AKUINO/MICHA/README.md

# MICHA
Modbus Interface to Control Heat and Actuators
