AKUINO/MICHA/MICHA20/Technical documentations/MICHA20_internalPinMatching.jpg

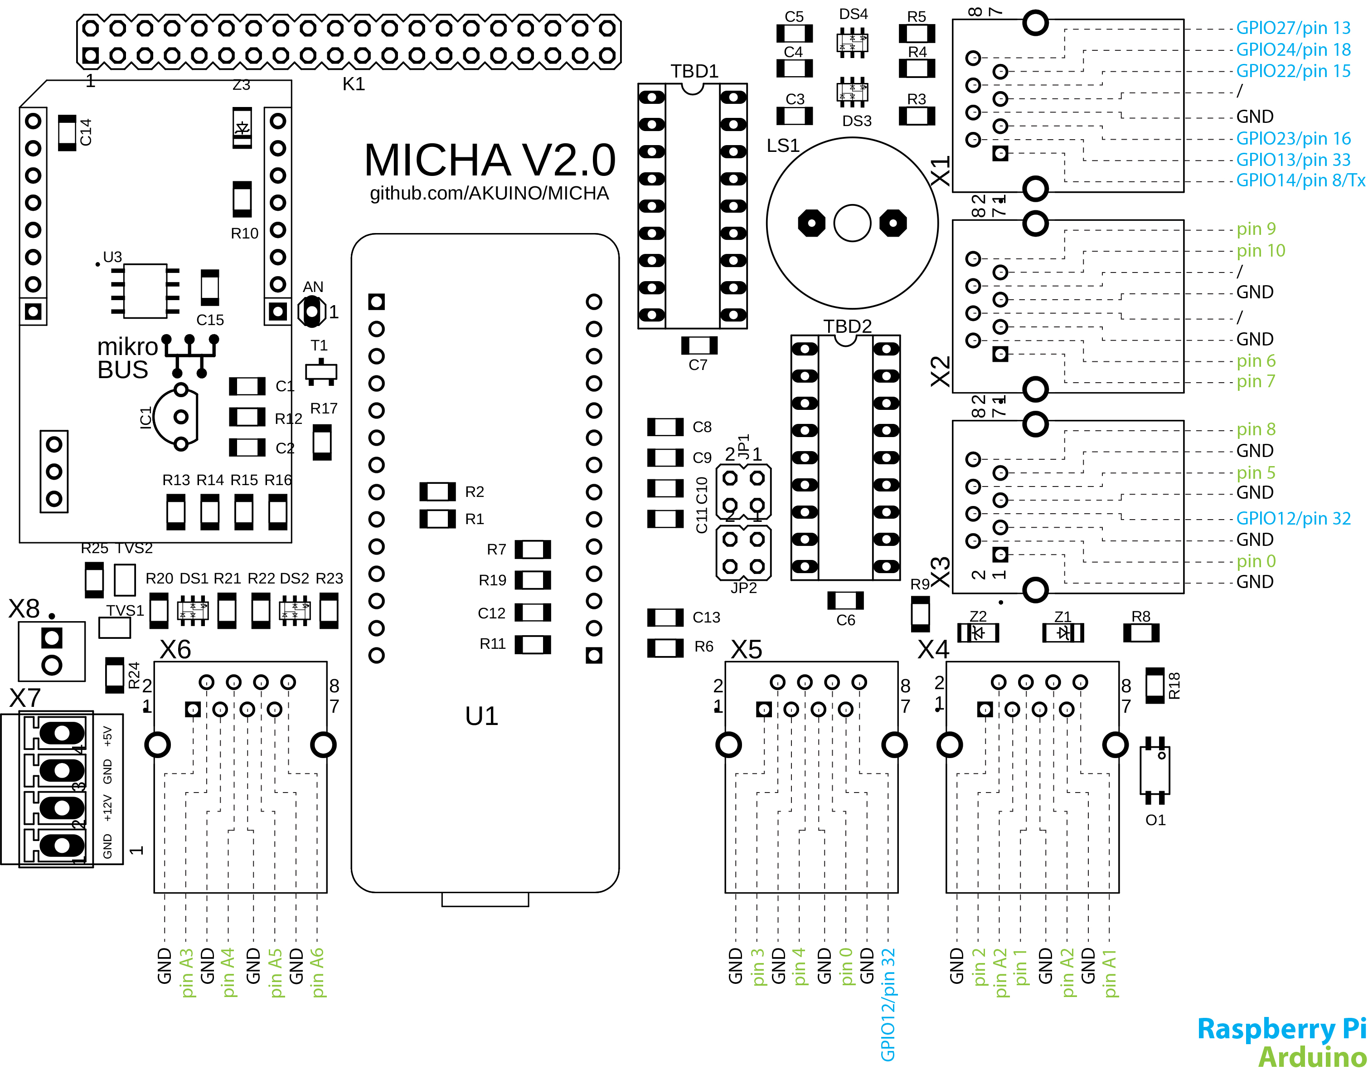
MICHA20/Technical documentations/MICHA20_internalPinMatching.jpg
