AKUINO/MICHA/MICHA20/Technical documentations/principleDiagram.jpg

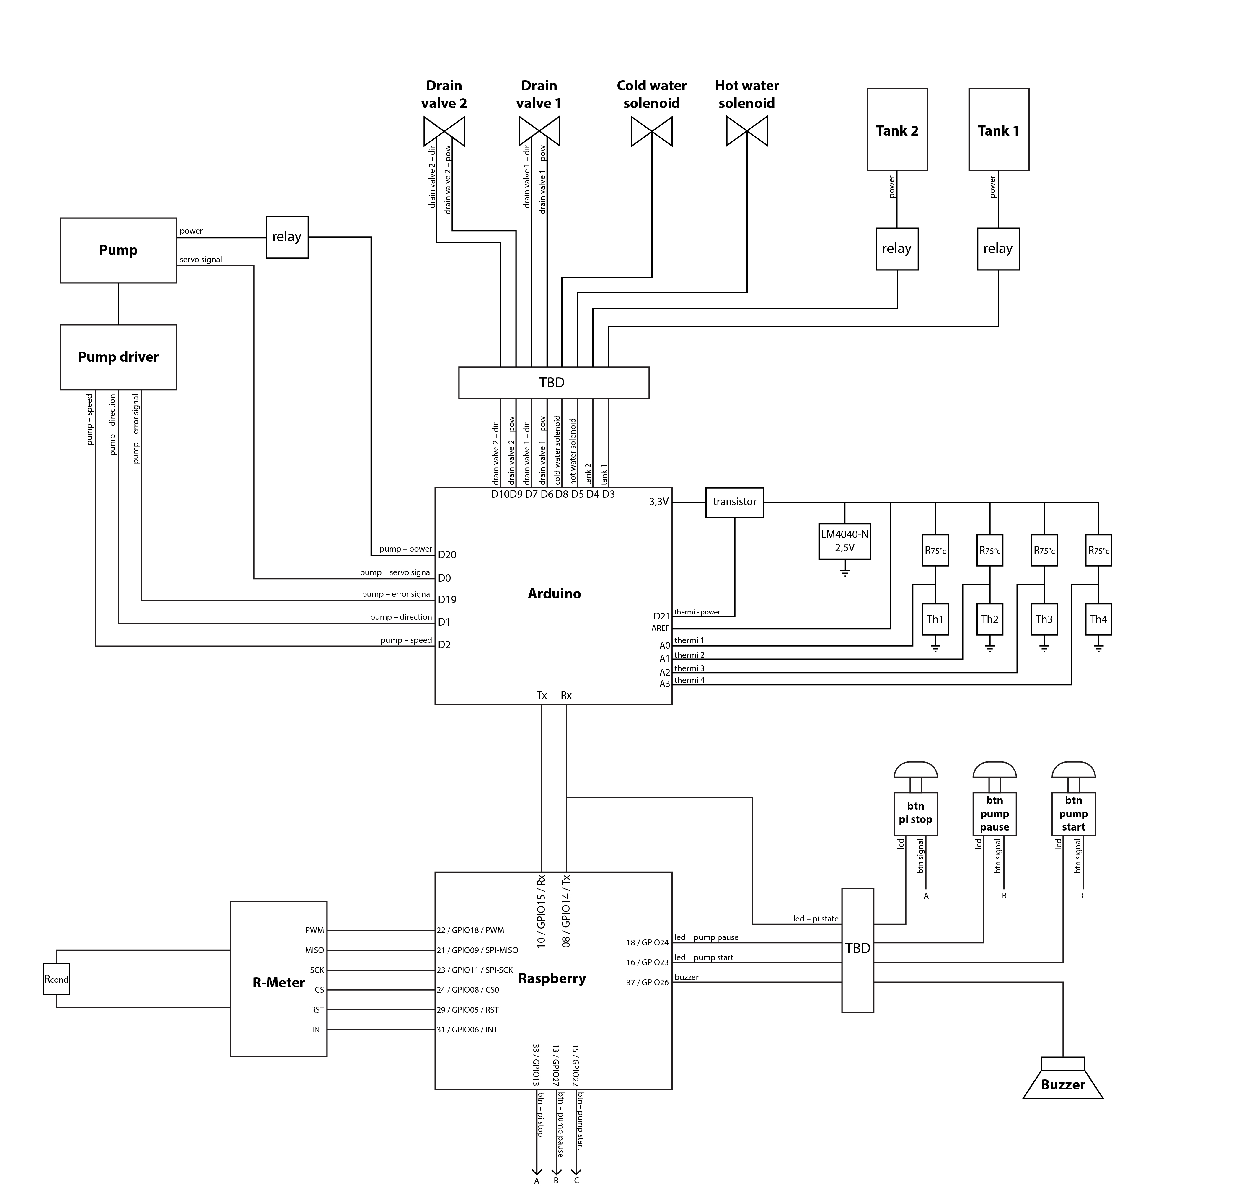
MICHA20/Technical documentations/principleDiagram.jpg
