AKUINO/MICHA/MICHA50/Technical documentations/MICHA50_BOM_PCB.pdf

### MICHA_V5.0

Prix toyal HT : | 172,27 €
Reference | Schematic Ref. | Type | Description | R o H S
U
E | Qty Stock | To
| | | | | | | order | unit | Unit€ | Transp€ | EXT | U R L
| | | | | | | | | | | | 1 U R L
| | | | | | | | | | | | 2 U R L
| | | | | | | | | | | | 3 BOM Note
NBR PASTO: | 2
C1206C104K5RACTU/GR0004 | C1-C5 | Capacitor | Condensateur tantal 100nF 1206 (3216) | (Y) | 5 | 118 | 0 | / | 0,12 € | ? | 0,62 € | https://be.farnell.com/fr-BE/kemet/c1206c104k5ractu/condensateur-0-1-f-50v-10-x7r/dp/1414715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
CL31B105KAHNNNE/GR0003 | C6 | Capacitor | Condensateur céramique 1µF 1206(3216) | (Y) | 1 | 88 | 0 | / | 0,04 € | ? | 0,04 € | https://www.mouser.be/ProductDetail/Samsung-Electro-Mechanics/CL31B105KAHNNNE?qs=349EhDEZ59p5FHnPIxx1UQ%3D%3D
C1206C103J1RACTU | C7-C10 | Capacitor | Condensateur céramique 10nF 1206 (3216) | (Y) | 4 | 73 | 0 | / | 0,09 € | ? | 0,36 € | C1206C103J1RACTU (https://www.tme.eu/be/fr/details/c1206c103j1ractu/condensateurs-mlcc-smd-1206/kemet/) KEMET - Condensateur: céramique | MLCC; 10nF; 100VDC; X7R; ±5%; SMD; 1206 | TME - Composants électroniques
CMXSH2-4LSTRPBFREE | DS1-DS5 | Diode | Diode Schottky 0,42V SOT-26 | (Y) | 5 | 17 | 0 | / | 0,75 € | ? | 3,77 € | CMXSH2-4LS (https://www.mouser.be/ProductDetail/Central-Semiconductor/CMXSH2-4LS-TR-PBFREE?qs=u16ybLDytRbULv8il3sGwg%3D%3D) TR PBFREE Central Semiconductor | Mouser Belgique
0ZCJ0005FF2E | F1 | Protection | Fusible réarmable 50mA | (Y) | 1 | 9 | 0 | / | 0,11 € | ? | 0,11 € | https://www.mouser.be/ProductDetail/Bel-Fuse/0ZCJ0005FF2E?qs=sGAEpiMZZMtJbfcMcIM8CEEKpmRzSeLfp9xT10Llxtc%3D https://be.farnell.com/fr-BE/bel-fuse-circuit-protection/0zcj0005ff2e/fusible-ctp-rearmable-60vdc-0/dp/2834879 Protection contre les court-circuits de X2, X4 et PUMP_DIR
LM4040AIM3X-2.5/GR0011 | IC1 | Diode | Référentiel de tension 2,5V SOT-23 | | 1 | 3 | 0 | / | 2,98 € | ? | 2,98 € | https://www.arrow.com/en/products/lm4040aim3x-2.5/texas-instruments?q=LM4040AIM3X-2.5 Pour tension de référence analogique précise du MKR
2202982 | K1 | PCB connector embase/socket GPIO 2*20 pins traversant | (Y) | 1 | 1 | 1 | / | 5,31 € | ? | 5,31 € | 2202982 (https://befr.rs-online.com/web/p/enclosure-accessories/1224301/?searchHistory={%22enabled%22%3Atrue}) | Phoenix Contact Socket Strip for use with Additional PCB, GPIOs of the Raspberry Pi, RPI-BC INT-PCB SET Perfboard | RS Components (rs-online.com) Pour venir connecter le Odroid
| | | | | | | | | | | | + 1 pour rehausser l'Odroid
BMT1612XH14 | LS1 | PCB component Buzzer 12V traversant | (Y) | 1 | 1 | 1 | / | 1,07 € | ? | 1,07 € | https://www.tme.eu/be/en/details/bmt-1612xh14/electromagnetic-sounders-with-generator/bestar/bmt1612xh14/
WR12X1000FTL/GR0001 | R1-R2, R11 | Resistor | Résistance 100R 1206 (3216) | (Y) | 3 | 19 | 0 | / | 0,02 € | ? | 0,05 € | https://be.farnell.com/fr-BE/walsin/wr12x1000ftl/res-couche-epaisse-100r-1-200v/dp/2502602?ost=2502602 Rx et Tx et la gate du MOSFET
MC0125W120611K15 | R3-R5, R8, R10 | Resistor | Résistance 1k15 1206 (3216) | (Y) | 5 | 225 | 0 | / | ? | ? | ? | https://be.farnell.com/fr-BE/multicomp/mc0125w120611k15/res-couche-epaisse-1-15k-1-0-125w/dp/2142185RL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 J'avais prévu des 1k, mais cette valeur (1k15) était en stock...
MCR18EZPF1004 | R6-R7 | Resistor | Résistance 1M 1206 (3216) | (Y) | 2 | 96 | 0 | / | 0,02 € | ? | 0,04 € | ROHM (https://befr.rs-online.com/web/p/surface-mount-fixed-resistors/9013749) 1MΩ, 1206 (3216M) Thick Film SMD Resistor ±1% 0.25W - MCR18EZPF1004 | RS Components (rs-online.com) Pull-down
HP06W2J0161T5E | R9, R12 | Resistor | Résistance 160R 1/2W 1206 (3216) | (Y) | 2 | 36 | 0 | / | 0,04 € | ? | 0,09 € | https://www.tme.eu/be/en/details/hp06-160r5%25/1206-smd-resistors/royal-ohm/hp06w2j0161t5e/ La valeur de R9 doit être comprise entre 35 et 174 ohms, en privilégiant le rapprochement à 174 ohms. La valeur R12 doit être comprise entre 52 et 231 ohms, en privilégiant le rapprochement à 231 ohms
AR06BTCV2001 | R13-R16 | Resistor | Résistance 2k 0,1% 1206 (3216) | (Y) | 4 | 75 | 0 | / | 0,13 € | ? | 0,53 € | AR06BTCV2001 (https://www.tme.eu/fr/details/ar1206-2k-0.1%25/resistances-de-precision-smd-1206/viking/ar06btcv2001/) Viking - Résistance: thin film | de précision; SMD; 1206; 2kΩ; 0,25W; ±0,1%; AR1206-2K-0.1% | TME - Composants électroniques
AR06BTCV1002/GR0005 | R17 | Resistor | Résistance 10k 1206 (3216) | (Y) | 1 | 95 | 0 | / | 0,13 € | ? | 0,13 € | AR06BTCV1002 (https://www.tme.eu/fr/details/ar1206-10k-0.1%25/resistances-de-precision-smd-1206/viking/ar06btcv1002/) Viking - Résistance: thin film | de précision; SMD; 1206; 10kΩ; 0,25W; ±0,1%; AR1206-10K-0.1% | TME - Composants électroniques Pull up
CRCW12065M60FKEA | R18 | Resistor | Résistance 5,6M 1206 (3216) | (Y) | 1 | 8 | 0 | / | 0,07 € | ? | 0,07 € | https://www.mouser.be/ProductDetail/Vishay-Dale/CRCW12065M60FKEA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
ERJ8GEYJ205V | R19 | Resistor | Résistance 2M 1206 (3216) | (Y) | 1 | 8 | 0 | / | 0,04 € | ? | 0,04 € | https://www.mouser.be/ProductDetail/Panasonic/ERJ-8GEYJ205V?qs=Ow%252BOiPmaljGQbguPb79h1w%3D%3D Panasonic (https://befr.rs-online.com/web/p/surface-mount-fixed-resistors/8127134) 2MΩ, 1206 (3216M) Thick Film SMD Resistor ±5% 0.25W - ERJ8GEYJ205V | RS Components (rs-online.com)
ERJ-P08D33R0V | R20-R23 | Resistor | Résistance 33R 1206 (3216) | (Y) | 4 | 12 | 0 | / | 0,29 € | ? | 1,15 € | ERJ-P08D33R0V (https://www.mouser.be/ProductDetail/Panasonic/ERJ-P08D33R0V?qs=sGAEpiMZZMvdGkrng054t5hHekyimr99UaPO9LKWRes%3D) Panasonic | Mouser Belgique Résistance de limitation de courant en cas
de surtension

Commutateur d'excitation des thermistances + commutation signal PUMP_DIR (partie puissance)

https://www.mouser.be/ProductDetail/Nexperia/NX3008NBK215?qs=N31o%252Bt096gsOHqYfhTnHuQ%3D%3D Pour commuter signal PUMP_DIR (partie commande) https://befr.rs-online.com/web/p/mosfets/8160576P/

M20-9990546 | RTC | PCB connector pin header 1*5 pins mâle traversant | 1 | 9 | 0 | / | 0,15 € | ? | 0,15 € | https://www.mouser.be/ProductDetail/Harwin/M20-9990546?qs=ulE8k0yEMYY8EKyDN9ic6A%3D%3D https://befr.rs-online.com/web/p/pcb-headers/6812985 Pour connecter module RTC
FDV304P | T1, T3 | Transistor | MOSFET canal P (high side) SOT-23 | (Y) | 2 | 17 | 0 | / | 0,31 € | ? | 0,62 € | P-Ch (https://befr.rs-online.com/web/p/mosfets/3544913/)annel (https://www.tme.eu/fr/details/fdv304p/transistors-avec-canal-p-smd/onsemi/) MOSFET, 460 mA, 25 V, 3-Pin SOT-23 onsemi FDV304P | RS Components (rs-online.com) FDV304P (https://www.tme.eu/fr/details/fdv304p/transistors-avec-canal-p-smd/onsemi/) ONSEMI - Transistor: P-MOSFET | unipolaire; -25V; -0,46A; 0,35W; SOT23 | TME - Composants électroniques
NX3008NBK,215 | T2 | Transistor | MOSFET canal N (low side) 400mA SOT-23 | (Y) | 1 | 8 | 0 | / | 0,10 € | ? | 0,10 € | https://be.farnell.com/fr-BE/nexperia/nx3008nbk-215/mosfet-n-ch-30v-400ma-sot23/dp/2069541?st=nx3008nbk (https://www.mouser.be/ProductDetail/Nexperia/NX3008NBK215?qs=N31o%252Bt096gsOHqYfhTnHuQ%3D%3D)
TBD62783APG | TBD | Transistor | Transistor array canal N traversant DIP18 | (Y) | 1 | 12 | 0 | / | 1,32 € | ? | 1,32 € | TBD62783APG (https://www.mouser.be/ProductDetail/Toshiba/TBD62783APG/) Toshiba | Mouser Belgique
ABX00012 | U1 | µController | Arduino MKR Zero | | 1 | 1 | 1 | / | 21,64 € | ? | 21,64 € | ABX00012 (https://befr.rs-online.com/web/p/arduino/1697584/?searchHistory=%7B%22enabled%22%3Atrue%7D) | Arduino, MKR ZERO (I2S Bus & SD for Sound, Music & Digital Audio Data) | RS Components (rs-online.com)
TBP03R2-350-09BE | X1 | PCB connector Socket bornier 9 voies 3,5mm vertical pluggable | (Y) | 1 | 0 | 2 | / | 0,71 € | ? | 0,71 € | TBP03R2-350-09BE (https://www.mouser.be/ProductDetail/CUI-Devices/TBP03R2-350-09BE?qs=TCDPyi3sCW1ZYkEl%2FuOYIA%3D%3D) CUI Devices | Mouser Belgique Pour boutons
TBP03R2-350-02BE/GR0012 | X2-EXT, X3 | PCB connector Socket bornier 2 voies 3,5mm vertical pluggable | (Y) | 2 | 8 | 0 | / | 0,17 € | ? | 0,33 € | https://www.mouser.be/ProductDetail/CUI-Devices/TBP03R2-350-02BE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 Pour l'entrée/sortie de réserve et l'alimentation
TBP03R2-350-03BE | X2-SOL | PCB connector Socket bornier 3 voies 3,5mm vertical pluggable | (Y) | 1 | 0 | 2 | / | 0,27 € | ? | 0,27 € | TBP03R2-350-03BE (https://www.mouser.be/ProductDetail/CUI-Devices/TBP03R2-350-03BE?qs=TCDPyi3sCW0MNogtBgeh9g%3D%3D) CUI Devices | Mouser Belgique Pour le solénoide
TBP03R2-350-04BE | X4 | PCB connector Socket bornier 4 voies 3,5mm vertical pluggable | (Y) | 1 | 0 | 2 | / | 0,34 € | ? | 0,34 € | TBP03R2-350-04BE (https://www.mouser.be/ProductDetail/CUI-Devices/TBP03R2-350-04BE?qs=TCDPyi3sCW2FBzZRcTfF1A%3D%3D) CUI Devices | Mouser Belgique Pour capteurs de niveau
SS7188S-A-NF | X5 | PCB connector Connecteur RJ45 blindé traversant | 1 | 2 | 0 | / | 2,78 € | ? | 2,78 € | SS-7188S-A-NF (https://befr.rs-online.com/web/p/ethernet-connectors/0437165/) | Bel-Stewart, Female Cat5e RJ45 Connector | RS Components (rs-online.com) Pour thermistances
TBP03R2-350-08BE | X6 | PCB connector Socket bornier 8 voies 3,5mm vertical pluggable | (Y) | 1 | 0 | 2 | / | 0,64 € | ? | 0,64 € | TBP03R2-350-08BE (https://www.mouser.be/ProductDetail/CUI-Devices/TBP03R2-350-08BE?qs=TCDPyi3sCW2GDID7GTUWUw%3D%3D) CUI Devices | Mouser Belgique Pour relais et driver pompe
SMAZ5V1-13-F | Z1 | Diode | Diode Zener 5,1V/1W SMA | (Y) | 1 | 0 | 2 | / | 0,30 € | ? | 0,30 € | SMA (https://www.tme.eu/be/fr/details/smaz5v1-13-f/diodes-zener-smd/diodes-incorporated/)Z5V1-13-F (https://befr.rs-online.com/web/p/zener-diodes/7515054/) DIODES INCORPORATED - Diode: Zener | 1W; 5,1V; 196mA; SMD; rouleau,bande; SMA; diode simple | TME - Composants électroniques SMAZ5V1-13-F (https://befr.rs-online.com/web/p/zener-diodes/7515054/) | Diodes Inc, 5.1V Zener Diode 5% 1 W SMT 2-Pin SMA | RS Components (rs-online.com)
DS1023-1*14S21 | Hors PCB | PCB connector embase/socket femelle 1*14 voies traversant | (Y) | 2 | 0 | 4 | / | 0,14 € | ? | 0,28 € | DS1023-1*14S21 (https://www.tme.eu/be/fr/details/zl262-14sg/barres-et-socles-a-broches/connfly/ds1023-1-14s21/) CONNFLY - Socle | broches; femelle; PIN: 14; droit; 2,54mm; THT; 1x14; doré; 3A; ZL262-14SG | TME - Composants électroniques Support Arduino MKR
DS1009-18AT1NX/GR0006 | Hors PCB | PCB connector embase/socket DIP18 femelle traversant | (Y) | 1 | 0 | 2 | / | 0,11 € | ? | 0,11 € | DS1009-18AT1NX (https://www.tme.eu/fr/details/icvt-18p/supports-dip-standard/connfly/ds1009-18at1nx/) CONNFLY - Support: DIP | PIN: 18; 7,62mm; THT; Trame: 2,54mm; ICVT-18P | TME - Composants électroniques Support TBD
P000054 | Hors PCB | Board | Odroid C4 4GB | | 1 | 0 | 2 | / | 59,99 € | 1,00 € | 60,99 € | Odroid (https://www.odroid.nl/index.php?route=product/product&product_id=1027) C4 - 4GB (https://wiki.odroid.com/odroid-c4/hardware/hardware) 64-bit quad-core Single Board Computer odroid-c4:hardware:hardware (https://wiki.odroid.com/odroid-c4/hardware/hardware) [ODROID Wiki]
P000055 | Hors PCB | Board | Module eMMC 16GB pour Odroid C4 avec Linux | | 1 | 0 | 2 | / | 19,99 € | 1,00 € | 20,99 € | Odroid (https://www.odroid.nl/odroid-accessories/odroid-os?product_id=1029) Operating System - 16GB eMMC Module C4 Linux
P000056 | Hors PCB | Board | RTC shield for Odroid C4 (with battery) | 1 | 1 | 1 | / | 5,99 € | 1,00 € | 6,99 € Odroid (https://www.odroid.nl/index.php?route=product/product&product_id=1038&search=rtc) RTC Shield for Odroid C4
TBP03P3-350-02BE | Hors PCB | Terminal | Bornier 2 voies 3,5mm femelle vertical | (Y) | 2 | 0 | 4 | / | 0,37 € | ? | 0,74 € | https://www.mouser.be/ProductDetail/CUI-Devices/TBP03P3-350-02BE?qs=TCDPyi3sCW3uWS2DeWnNnQ%3D%3D Pour l'entrée/sortie de réserve et l'alimentation
TBP03P3-350-03BE | Hors PCB | Terminal | Bornier 3 voies 3,5mm femelle vertical | (Y) | 1 | 0 | 2 | / | 0,56 € | ? | 0,56 € | TBP03P3-350-03BE (https://www.mouser.be/ProductDetail/CUI-Devices/TBP03P3-350-03BE?qs=TCDPyi3sCW1UCPAfivcr0A%3D%3D) CUI Devices | Mouser Belgique Pour le solénoide
TBP03P3-350-04BE | Hors PCB | Terminal | Bornier 4 voies 3,5mm femelle vertical | (Y) | 1 | 0 | 2 | / | 0,70 € | ? | 0,70 € | TBP03P3-350-04BE (https://www.mouser.be/ProductDetail/CUI-Devices/TBP03P3-350-04BE?qs=TCDPyi3sCW0N0GUIv2Pwmw%3D%3D) CUI Devices | Mouser Belgique Pour les capteurs de niveau
TBP03P3-350-08BE | Hors PCB | Terminal | Bornier 8 voies 3,5mm femelle vertical | (Y) | 1 | 0 | 2 | / | 1,27 € | ? | 1,27 € | TBP03P3-350-08BE (https://www.mouser.be/ProductDetail/CUI-Devices/TBP03P3-350-08BE?qs=TCDPyi3sCW3NPc58bFyaZw%3D%3D) CUI Devices | Mouser Belgique Pour les relais et la pompe
TBP03P3-350-09BE | Hors PCB | Terminal | Bornier 9 voies 3,5mm femelle vertical | (Y) | 1 | 0 | 2 | / | 1,42 € | ? | 1,42 € | TBP03P3-350-09BE (https://www.mouser.be/ProductDetail/CUI-Devices/TBP03P3-350-09BE?qs=TCDPyi3sCW3a3XlVrxVrcQ%3D%3D) CUI Devices | Mouser Belgique Pour boutons et témoins
P000066 | Hors PCB | Board | PCB MICHAv4.0 | 1 | 1 | 1 | / | 32,68 € | ? | 32,68 € https://www.eurocircuits.com

General Note

Dernière
vérification
du stock

RS
Components | Farnell | Mouser | TME | Vis-Express
/ | 02/02/23
/ | 02/02/23
/ | 02/02/23
Car SDM10M45SD-7-F difficilement trouvable...
ATTENTION: DISPOSITION DES PINS DIFFERENTES!!!
CMXSH2-4LS TR PBFREE | 02/02/23
Se déclenche à 150mA en 1,5s | 02/02/23
Tolérance de +-0,1% | 02/02/23
GPIO Header pour Raspberry | 02/02/23
Alternative identique au 780-0743 | 02/02/23
/ | 02/02/23
/ | 02/02/23
/ | 02/02/23

Tolérance de +-5%
| 02/02/23
Tolérance de +-0,1% | 02/02/23
/ | 02/02/23
/ | 02/02/23
/ | 02/02/23
/ | 02/02/23
Pas de 2,54mm | 02/02/23
/ | 02/02/23

Tension de seuil Vgs(off): 0,6 à 1,1V
Rds(on): 1 ohm
Pd: 350mW | 02/02/23
/ | 02/02/23
/ | 02/02/23
Pas de 3,5mm, vertical, mâle, détrompeur
Pas de 3,5mm, vertical, mâle, détrompeur | 02/02/23
Pas de 3,5mm, vertical, mâle, détrompeur
Pas de 3,5mm, vertical, mâle, détrompeur
Blindé | 02/02/23
Pas de 3,5mm, vertical, mâle, détrompeur
5,1V/1W | 02/02/23
Pas de 2,54mm, support Arduino MKR | 02/02/23
Support pour les TBD | 02/02/23
Alternative au RPi (sans wifi) | 02/02/23
Mémoire flash pour Odroid C4 avec Ubuntu 20.04 pré-installé | 02/02/23
Real Time Clock | 02/02/23
Bleu
Bleu
Bleu
Bleu
Bleu
Carte perso MICHA | 02/02/23
