AKUINO/MICHA/MICHA20/Technical documentations/MICHA20_BOM_PCB.pdf

## MICHA_V2.0

Reference | Schematic Ref. | Type | Description

R
o
H
S

U
E | Qty Stock unit | UnitTot | EXT | Info URL | BOM Note | General Note
GR0004 C1-C5, C14-C15 Capacitor Condensateur tantal 100nF 1206 (3216) C1206C105M4RACTU C6-C7 Capacitor Condensateur céramique 1µF 1206(3216) C1206C103J1RACTU C8-C13 Capacitor Condensateur céramique 10nF 1206 (3216) (Y) | 7,0 123 | / 0,25 € 1,76 € https://be.farnell.com/fr-BE/kemet/c1206c104k5ractu/condensateur-0-1-f-50v-10-x7r/dp/1414715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
| 2,0 0 | / 0,15 € 0,30 € C1206C105M4RACTU (https://www.tme.eu/be/fr/details/c1206c105m4ractu/condensateurs-mlcc-smd-1206/kemet/) KEMET - Condensateur: céramique | MLCC; 1uF; 16VDC; X7R; ±20%; SMD; 1206 | TME - Composants électroniques /
| 6,0 77 | / 0,09 € 0,54 € C1206C103J1RACTU (https://www.tme.eu/be/fr/details/c1206c103j1ractu/condensateurs-mlcc-smd-1206/kemet/) KEMET - Condensateur: céramique | MLCC; 10nF; 100VDC; X7R; ±5%; SMD; 1206 | TME - Composants électroniques /
SDM10M45SD-7-F | DS1-DS4 Diode Diode Schottky 0,45V SOT-26 (Y) | 4,0 6 | / 0,37 € 1,47 € SDM10M45SD-7-F (https://www.mouser.be/ProductDetail/Diodes-Incorporated/SDM10M45SD-7-F) Diodes Incorporated | Mouser Belgique /
LM4040AIZ-2.5/NOPB | IC1 | Diode | Référentiel de tension 2,5V TO-92 | 1,0 | 3 | / | 1,91 € | 1,91 € Texas Instruments (https://befr.rs-online.com/web/p/voltage-references/5343037/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) Fixed Shunt Voltage Reference 2.5V ±0.1 % 3-Pin TO-92, LM4040AIZ-2.5/NOPB | RS Components (rs-online.com) Tolérance de +-0,1%
2202982 | K1 | PCB connector embase/socket GPIO 2*20 pins traversant | (Y) | 1,0 | 3 | / | 5,31 € | 5,31 € 2202982 | Phoenix (https://befr.rs-online.com/web/p/enclosure-accessories/1224301/?searchHistory={%22enabled%22%3Atrue}) Contact Socket Strip for use with Additional PCB, GPIOs of the Raspberry Pi, RPI-BC INT-PCB SET Perfboard | RS Components (rs-online.com) GPIO Header pour Raspberry
780-0743 | LS1 | PCB component Buzzer 12V traversant | (Y) | 1,0 | 0 | / | 1,14 € | 1,14 € RS PRO 85dB, (https://befr.rs-online.com/web/p/piezo-buzzer-components/7800743/) Through Hole Continuous External Piezo Buzzer | RS Components (rs-online.com) Alternative identique au BMT1612XH14
HMHA281R2 | O1 | Phototransistor Optocoupleur boitier MFP | (Y) | 1,0 | 15 | / | 0,40 € | 0,40 € HMHA281R2 (https://fr.rs-online.com/web/p/optocoupleurs/8023256/) | Optocoupleur Montage en surface, ON Semiconductor, Sortie Phototransistor | RS Components (rs-online.com) Tension directe maximum: 1,3V
TC0625B1000T1E | R11 | Resistor | Résistance 100R 1206 (3216) | 1,0 | 0 | / | ? | ? TC0625B1000T1E (https://www.tme.eu/fr/details/tc0625b1000t1e/resistances-de-precision-smd-1206/royal-ohm/) ROYAL OHM - Résistance: thin film | de précision; SMD; 1206; 100Ω; 125mW; ±0,1% | TME - Composants électroniques (WFS) Rx et Tx et la gate du MOSFET | /
RN73H2BTTD1001B25 | R1-R5, R7, R10 | Resistor | Résistance 1k 1206 (3216) | 7,0 | 0 | / | 0,52 € | 3,63 € RN73H2BTTD1001B25 (https://www.mouser.be/ProductDetail/KOA-Speer/RN73H2BTTD1001B25/?qs=Zlm1YJ46fsD3WNngRPTY1g%3D%3D) KOA Speer | Mouser Belgique | /
CRCW1206680RFKEAC | R6 | Resistor | Résistance 680R 1206 (3216) | 1,0 | 96 | / | 0,07 € | 0,07 € | Pullup optocoupleur | /
AR06BTCV2001 | R13-R16, R19 | Resistor | Résistance 2k 0,1% 1206 (3216) | (Y) | 5,0 | 79 | / | 0,13 € | 0,66 € AR06BTCV2001 (https://www.tme.eu/fr/details/ar1206-2k-0.1%25/resistances-de-precision-smd-1206/viking/ar06btcv2001/) Viking - Résistance: thin film | de précision; SMD; 1206; 2kΩ; 0,25W; ±0,1%; AR1206-2K-0.1% | TME - Composants électroniques Tolérance de +-0,1%
HP06W2J0161T5E | R8-R9, R12 | Resistor | Résistance 160R 1/2W 1206 (3216) | (Y) | 3,0 | 38 | / | 0,04 € | 0,13 € https://www.tme.eu/be/en/details/hp06-160r5%25/1206-smd-resistors/royal-ohm/hp06w2j0161t5e/

La valeur de R8-R9 doit être comprise entre 35 et 174 ohms, en privilégiant le rapprochement à 174 ohms.
La valeur R12 doit être comprise entre 52 et 231 ohms,
en privilégiant le rapprochement à 231 ohms

Tolérance de +-5%

CRT1206-BY-1002ELF | R17 | Resistor | Résistance 10k 1206 (3216) | 1,0 | 0 | / | 0,57 € | 0,57 € Bourns 10kΩ, (https://befr.rs-online.com/web/p/surface-mount-fixed-resistors/6934495/) 1206 (3216M) Thin Film SMD Resistor ±0.1% 0.25W - CRT1206-BY-1002ELF | RS Components (rs-online.com) /
ERJP08F3900V | R18 | Resistor | Résistance 390R 1206 (3216) | (Y) | 1,0 | 7 | / | 0,21 € | 0,21 € ERJP08F3900V (https://fr.rs-online.com/web/p/resistances-cms/7219781/) | Résistance CMS 390Ω ±1%, série ERJP08, boitier 1206 (3216M) 0.66W, ±100ppm/°C | RS Components (rs-online.com) /
ERJ-P08D33R0V | R20-R25 | Resistor | Résistance 33R 1206 (3216) | (Y) | 6,0 | 6 | / | 0,29 € | 1,73 € ERJ-P08D33R0V (https://www.mouser.be/ProductDetail/Panasonic/ERJ-P08D33R0V?qs=sGAEpiMZZMvdGkrng054t5hHekyimr99UaPO9LKWRes%3D) Panasonic | Mouser Belgique Résistance de limitation de courant en cas
de surtension | /
FDV304P | T1 | Transistor | MOSFET canal P (high side) SOT-23 | (Y) | 1,0 | 19 | / | 0,31 € | 0,31 € P-Channel MOSFET, (https://befr.rs-online.com/web/p/mosfets/3544913/) 460 mA, 25 V, 3-Pin SOT-23 onsemi FDV304P | RS Components (rs-online.com) Commutateur d'excitation | /
TBD62783APG | TBD1-TBD2 | Transistor | Transistor array canal N traversant DIP18 | (Y) | 2,0 | 3 | / | 1,32 € | 2,64 € TBD62783APG (https://www.mouser.be/ProductDetail/Toshiba/TBD62783APG/) Toshiba | Mouser Belgique | /
TV02W6V0B-G | TVS1-TVS2 | Diode | Diode TVS 6V SOD-123 | (Y) | 2,0 | 8 | / | 0,26 € | 0,51 € TV02W6V0B-G (https://www.mouser.be/ProductDetail/Comchip-Technology/TV02W6V0B-G?qs=2qJf6qQ4IOK5OBXl05q1Zg%3D%3D) Comchip Technology | Mouser Belgique | Vwm=6V, Vc=10,3V, bidirectionnel
ABX00012 | U1 | µController | Arduino MKR Zero | 1,0 | 1 | / | 21,64 € | 21,64 € ABX00012 | Arduino, (https://befr.rs-online.com/web/p/arduino/1697584/?searchHistory=%7B%22enabled%22%3Atrue%7D) MKR ZERO (I2S Bus & SD for Sound, Music & Digital Audio Data) | RS Components (rs-online.com) /
MIKROE-2396 | U2 | µController | R-Meter click | 1,0 | 0 | / | 23,01 € | 23,01 € R Meter click (https://www.mikroe.com/r-meter-click) – board with circuitry for measuring resistor values (mikroe.com)/
MAX4528CSA+ | U3 | PCB component Commutateur analogique 2*SPDT SOIC-8 | 1,0 | 3 | / | 3,12 € | 3,12 € MAX4528CSA+ (https://www.mouser.be/ProductDetail/Maxim-Integrated/MAX4528CSA+?qs=1THa7WoU59HuGBOB0q03Ng==) Maxim Integrated | Mouser Belgique | /
SS7188S-A-NF | X1-X6 | PCB connector Connecteur RJ45 blindé traversant | 6,0 | 2 | / | 2,78 € | 16,68 € SS-7188S-A-NF (https://befr.rs-online.com/web/p/ethernet-connectors/0437165/) | Bel-Stewart, Female Cat5e RJ45 Connector | RS Components (rs-online.com) Blindé
2351886-4 | X7 | PCB connector Bornier 4 voies vertical pluggable | 1,0 | 0 | / | 0,32 € | 0,32 € 2351886-4 | TE (https://befr.rs-online.com/web/p/pcb-terminal-blocks/1951950/) Connectivity 4-pin PCB Terminal Block, 3.5mm Pitch | RS Components (rs-online.com) Pas de 3,5mm, vertical, mâle, détrompeur
1725656 | X8 | PCB connector Bornier 2 voies | (Y) | 1,0 | 4 | / | 1,47 € | 1,47 € 1725656 Phoenix (https://www.mouser.be/ProductDetail/Phoenix-Contact/1725656) Contact | Mouser Belgique | Pas de 2,54mm
SMAZ5V1-13-F | Z1-Z2 | Diode | Diode Zener 5,1V/1W SMA | (Y) | 2,0 | 1 | / | 0,30 € | 0,61 € SMAZ5V1-13-F (https://www.tme.eu/be/fr/details/smaz5v1-13-f/diodes-zener-smd/diodes-incorporated/) DIODES INCORPORATED - Diode: Zener | 1W; 5,1V; 196mA; SMD; rouleau,bande; SMA; diode simple | TME - Composants électroniques 5,1V/1W
1SMA5913BT3G | Z3 | Diode | Diode Zener 3,3V SMA | (Y) | 1,0 | 15 | / | 0,31 € | 0,31 € 1SMA5913BT3G (https://www.tme.eu/be/fr/details/1sma5913bt3g/diodes-zener-smd/onsemi/) ONSEMI - Diode: Zener | 1,5W; 3,3V; SMD; rouleau,bande; SMA; diode simple | TME - Composants électroniques /
1840382 | PCB connector Connecteur pour bornier 4 voies mâle | 2,0 | 0 | / | 4,66 € | 9,32 € MC 1,5/ 4-ST-3,5 (https://www.tme.eu/fr/details/mc1.5_4-st-3.5/borniers-de-serrage-deconnectables/phoenix-contact/mc-1-5-4-st-3-5-1840382/) 1840382 PHOENIX CONTACT - Barrette de pression amovible | 3,5mm; pistes: 4; droit; femelle; MC1.5/4-ST-3.5 | TME - Composants électroniques Version femelle de X7, plug à vis | Pour aller sur le bornier 4 voies vertical 2351886-4
A 18-LC-TT | PCB connector embase/socket DIP18 femelle traversant | 2,0 | 0 | / | 0,26 € | 0,52 € A 18-LC-TT | (https://befr.rs-online.com/web/p/dil-sockets/6742441/) ASSMANN WSW 2.54mm Pitch Vertical 18 Way, Through Hole Stamped Pin Open Frame IC Dip Socket, 1A | RS Components (rs-online.com) Support pour les TBD
SSW-114-01-T-S | PCB connector embase/socket femelle 1*14 voies traversant | 2,0 | 0 | / | 1,11 € | 2,23 € SSW-114-01-T-S (https://befr.rs-online.com/web/p/pcb-sockets/1557926/) | Samtec, SSW 2.54mm Pitch 14 Way 1 Row Straight PCB Socket, Through Hole, Solder Termination | RS Components (rs-online.com) Pas de 2,54mm, support Arduino MKR
SSW-108-03-T-S | PCB connector embase/socket femelle 1*8 voies traversant | 2,0 | 0 | / | 1,07 € | 2,14 € SSW-108-03-T-S (https://befr.rs-online.com/web/p/pcb-sockets/1800432) | Samtec, SSW 2.54mm Pitch 8 Way 1 Row Straight PCB Socket, Through Hole, Solder Termination | RS Components (rs-online.com) Pas de 2,54mm, support R-Meter
M20-9990246 | PCB connector pin header 1*2 pins mâle traversant | 4,0 | 0 | / | 0,06 € | 0,24 € M20-9990246 (https://befr.rs-online.com/web/p/pcb-headers/7457065) | HARWIN, M20, 2 Way, 1 Row, Straight Pin Header | RS Components (rs-online.com) Pas de 2,54mm, pour routage via jumper
AKSCT/Z BLACK | PCB connector Jumper femelle 1*2 voies | 1,0 | 0 | / | 0,22 € | 0,22 € AKSCT/Z BLACK (https://befr.rs-online.com/web/p/jumpers-shunts/6742397) | ASSMANN WSW Jumper Female Straight Black Closed Top 2 Way 1 Row 2.54mm Pitch | RS Components (rs-online.com) Pas de 2,54mm
M20-9990346 | PCB connector embase/socket femelle 1*3 voies traversant | 1,0 | 0 | / | 0,08 € | 0,08 € M20-9990346 (https://befr.rs-online.com/web/p/pcb-headers/7457068) | HARWIN, M20, 3 Way, 1 Row, Straight Pin Header | RS Components (rs-online.com) Pas de 2,54mm, pour accueillir sortie du R-Meter
P000029 | PCB connector pin header 1*3 pins mâle traversant | 1,0 | 0 | / | ? | ? | Pour sortie du R-Meter
DS3231S#T&R | PCB component RTC module I2C Maxim Integrated (https://res.cloudinary.com/rsc/image/upload/b_rgb:FFFFFF,c_pad,dpr_1.0,f_auto,q_auto,w_700/c_pad,w_700/P1905219-01) | (Y) | 1,0 | 0 | / | 8,78 € | 8,78 € Maxim Integrated (https://befr.rs-online.com/web/p/real-time-clocks/1905219) DS3231S#T&R, Real Time Clock Serial-I2C, 16-Pin SOIC | RS Components (rs-online.com) Pour le module RTC | La seule différence avec le DS3231S# est le packaging (en bande et rouleau pour le T&R)

## MICHA_V2.0
