AKUINO/MICHA/MICHA40/Technical documentations/MICHA40_BOM_PCB.pdf

### MICHA_V4.0

Les BOM sont a | Schematic Ref. | Type | Description | R o H S
U
E | Qty Stock unit | UnitTot | EXT
| | | | | | | | | U R L
| | | | | | | | | 1 U R L
| | | | | | | | | 2 U R L
| | | | | | | | | 3
| | | | | | | | | BOM Note | General Note
GR0004 | C1-C5 | Capacitor | Condensateur tantal 100nF 1206 (3216) | 5 | 123 | / | 0,25 € | 1,26 € https://be.farnell.com/fr-BE/kemet/c1206c104k5ractu/condensateur-0-1-f-50v-10-x7r/dp/1414715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
GR0003 | C6 | Capacitor | Condensateur céramique 1µF 1206(3216) | 1 | 89 | / | 0,15 € | 0,15 € https://www.mouser.be/ProductDetail/Samsung-Electro-Mechanics/CL31B105KAHNNNE?qs=349EhDEZ59p5FHnPIxx1UQ%3D%3D
C1206C103J1RACTU | C7-C10 | Capacitor | Condensateur céramique 10nF 1206 (3216) | (Y) | 4 | 77 | / | 0,09 € | 0,36 € C1206C103J1RACTU (https://www.tme.eu/be/fr/details/c1206c103j1ractu/condensateurs-mlcc-smd-1206/kemet/) KEMET - Condensateur: céramique | MLCC; 10nF; 100VDC; X7R; ±5%; SMD; 1206 | TME - Composants électroniques /
CMXSH2-4LS TR PBFREE | DS1-DS5 | Diode | Diode Schottky 0,42V SOT-26 | (Y) | 5 | 5 | / | 0,75 € | 3,77 € CMXSH2-4LS (https://www.mouser.be/ProductDetail/Central-Semiconductor/CMXSH2-4LS-TR-PBFREE?qs=u16ybLDytRbULv8il3sGwg%3D%3D) TR PBFREE Central Semiconductor | Mouser Belgique | Car SDM10M45SD-7-F difficilement trouvable... ATTENTION: DISPOSITION DES PINS DIFFERENTES!!!
0ZCJ0005FF2E | F1 | Protection | Fusible réarmable 50mA | (Y) | 1 | 9 | / | 0,11 € | 0,11 € https://www.mouser.be/ProductDetail/Bel-Fuse/0ZCJ0005FF2E?qs=sGAEpiMZZMtJbfcMcIM8CEEKpmRzSeLfp9xT10Llxtc%3D https://be.farnell.com/fr-BE/bel-fuse-circuit-protection/0zcj0005ff2e/fusible-ctp-rearmable-60vdc-0/dp/2834879 Protection contre les court-circuits de X2, X4 et PUMP_DIR | Se déclenche à 150mA en 1,5s
GR0011 | IC1 | Diode | Référentiel de tension 2,5V SOT-23 | | 1 | 4 | / | 2,98 € | 2,98 € https://www.digikey.com/en/products/detail/LM4040AIM3X-2.5/296-37694-1-ND/3700266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 Pour tension de référence analogique précise du MKR | Tolérance de +-0,1%
2202982 | K1 | PCB connector embase/socket GPIO 2*20 pins traversant | (Y) | 2 | 3 | / | 5,31 € | 10,62 € 2202982 (https://befr.rs-online.com/web/p/enclosure-accessories/1224301/?searchHistory={%22enabled%22%3Atrue}) | Phoenix Contact Socket Strip for use with Additional PCB, GPIOs of the Raspberry Pi, RPI-BC INT-PCB SET Perfboard | RS Components (rs-online.com) Pour venir connecter le Odroid
+ 1 pour rehausser l'Odroid GPIO Header pour Raspberry

La valeur de R9 doit être comprise entre 35 et 174 ohms, en privilégiant le rapprochement à 174 ohms. Tolérance de +-5% La valeur R12 doit être comprise entre 52 et 231 ohms, en privilégiant le rapprochement à 231 ohms

de surtension /

BMT1612XH14 | LS1 | PCB component Buzzer 12V traversant | (Y) | 1 | 2 | / | 1,07 € | 1,07 € https://www.tme.eu/be/en/details/bmt-1612xh14/electromagnetic-sounders-with-generator/bestar/bmt1612xh14/ Alternative identique au 780-0743
GR0001 | R1-R2, R11 | Resistors | Résistance 100R 1206 (3216) | | 3 | 22 | / | 0,13 € | 0,40 € https://be.farnell.com/fr-BE/walsin/wr12x1000ftl/res-couche-epaisse-100r-1-200v/dp/2502602?ost=2502602 Rx et Tx et la gate du MOSFET | /
MC0125W120611K15 | R3-R5, R8, R10, R24-R25 | Resistor | Résistance 1k15 1206 (3216) | (Y) | 7 | 232 | / | ? | ? https://be.farnell.com/fr-BE/multicomp/mc0125w120611k15/res-couche-epaisse-1-15k-1-0-125w/dp/2142185RL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 J'avais prévu des 1k, mais cette valeur (1k15) était en stock... /
MCR18EZPF1004 | R6-R7 | Resistor | Résistance 1M 1206 (3216) | (Y) | 2 | 98 | / | 0,02 € | 0,04 € ROHM (https://befr.rs-online.com/web/p/surface-mount-fixed-resistors/9013749) 1MΩ, 1206 (3216M) Thick Film SMD Resistor ±1% 0.25W - MCR18EZPF1004 | RS Components (rs-online.com) Pull-down | /
HP06W2J0161T5E | R9, R12 | Resistor | Résistance 160R 1/2W 1206 (3216) | (Y) | 2 | 38 | / | 0,04 € | 0,09 € https://www.tme.eu/be/en/details/hp06-160r5%25/1206-smd-resistors/royal-ohm/hp06w2j0161t5e/
AR06BTCV2001 | R13-R16 | Resistor | Résistance 2k 0,1% 1206 (3216) | (Y) | 4 | 79 | / | 0,13 € | 0,53 € AR06BTCV2001 (https://www.tme.eu/fr/details/ar1206-2k-0.1%25/resistances-de-precision-smd-1206/viking/ar06btcv2001/) Viking - Résistance: thin film | de précision; SMD; 1206; 2kΩ; 0,25W; ±0,1%; AR1206-2K-0.1% | TME - Composants électroniques Tolérance de +-0,1%
GR0005 | R17 | Resistors | Résistance 10k 1206 (3216) | | 1 | 96 | / | 0,57 € | 0,57 € AR06BTCV1002 (https://www.tme.eu/fr/details/ar1206-10k-0.1%25/resistances-de-precision-smd-1206/viking/ar06btcv1002/) Viking - Résistance: thin film | de précision; SMD; 1206; 10kΩ; 0,25W; ±0,1%; AR1206-10K-0.1% | TME - Composants électroniques Pull up | /
CRCW12065M60FKEA | R18 | Resistor | Résistance 5,6M 1206 (3216) | (Y) | 1 | 9 | / | 0,07 € | 0,07 € https://www.mouser.be/ProductDetail/Vishay-Dale/CRCW12065M60FKEA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 /
ERJ8GEYJ205V | R19 | Resistor | Résistance 2M 1206 (3216) | (Y) | 1 | 9 | / | 0,04 € | 0,04 € https://www.mouser.be/ProductDetail/Panasonic/ERJ-8GEYJ205V?qs=Ow%252BOiPmaljGQbguPb79h1w%3D%3D Panasonic (https://befr.rs-online.com/web/p/surface-mount-fixed-resistors/8127134) 2MΩ, 1206 (3216M) Thick Film SMD Resistor ±5% 0.25W - ERJ8GEYJ205V | RS Components (rs-online.com) /
ERJ-P08D33R0V | R20-R23 | Resistor | Résistance 33R 1206 (3216) | (Y) | 4 | 6 | / | 0,29 € | 1,15 € ERJ-P08D33R0V (https://www.mouser.be/ProductDetail/Panasonic/ERJ-P08D33R0V?qs=sGAEpiMZZMvdGkrng054t5hHekyimr99UaPO9LKWRes%3D) Panasonic | Mouser Belgique Résistance de limitation de courant en cas
M20-9990546 | RTC | PCB connector pin header 1*5 pins mâle traversant | 1 | 0 | / | 0,15 € | 0,15 € https://www.mouser.be/ProductDetail/Harwin/M20-9990546?qs=ulE8k0yEMYY8EKyDN9ic6A%3D%3D https://befr.rs-online.com/web/p/pcb-headers/6812985 Pour connecter module RTC | Pas de 2,54mm
FDV304P | T1, T3 | Transistor | MOSFET canal P (high side) SOT-23 | (Y) | 2 | 19 | / | 0,31 € | 0,62 € P-Ch (https://befr.rs-online.com/web/p/mosfets/3544913/)annel (https://www.tme.eu/fr/details/fdv304p/transistors-avec-canal-p-smd/onsemi/) MOSFET, 460 mA, 25 V, 3-Pin SOT-23 onsemi FDV304P | RS Components (rs-online.com) FDV304P (https://www.tme.eu/fr/details/fdv304p/transistors-avec-canal-p-smd/onsemi/) ONSEMI - Transistor: P-MOSFET | unipolaire; -25V; -0,46A; 0,35W; SOT23 | TME - Composants électroniques
| | | | | | | | | Commutateur d'excitation des thermistances
| | | | | | | | | + commutation signal PUMP_DIR (partie puissance) | /
NX3008NBK,215 | T2 | Transistor | MOSFET canal N (low side) 400mA SOT-23 | (Y) | 1 | 9 | / | 0,10 € | 0,10 € https://be.farnell.com/fr-BE/nexperia/nx3008nbk-215/mosfet-n-ch-30v-400ma-sot23/dp/2069541?st=nx3008nbk https://befr.rs-online.com/web/p/mosfets/8160576P/ https://www.mouser.be/ProductDetail/Nexperia/NX3008NBK215?qs=N31o%252Bt096gsOHqYfhTnHuQ%3D%3D Pour commuter signal PUMP_DIR (partie commande) | Tension de seuil Vgs(off): 0,6 à 1,1V
| | | | | | | | | | Rds(on): 1 ohm
| | | | | | | | | | Pd: 350mW
TBD62783APG | TBD | Transistor | Transistor array canal N traversant DIP18 | (Y) | 1 | 3 | / | 1,32 € | 1,32 € TBD62783APG (https://www.mouser.be/ProductDetail/Toshiba/TBD62783APG/) Toshiba | Mouser Belgique | /
ABX00012 | U1 | µController | Arduino MKR Zero | 1 | 1 | / | 21,64 € | 21,64 € ABX00012 (https://befr.rs-online.com/web/p/arduino/1697584/?searchHistory=%7B%22enabled%22%3Atrue%7D) | Arduino, MKR ZERO (I2S Bus & SD for Sound, Music & Digital Audio Data) | RS Components (rs-online.com) /
105310-1110 | X1 | Electronic connectorMolex nano-fit 10 pins pitch 2,5mm header | (Y) | 1 | 9 | / | 1,73 € | 1,73 € https://be.farnell.com/molex/105310-1110/conn-header-10pos-2row-2-5mm/dp/3862779?ost=105310-1110 https://www.mouser.be/ProductDetail/Molex/105310-1110?qs=PqFvFmEiOr6xTZJaWkdhvQ%3D%3D Pour boutons | Va de paire avec 105308-1210
105310-1106 | X2 | Electronic connectorMolex nano-fit 6 pins pitch 2,5mm header | (Y) | 1 | 9 | / | 1,18 € | 1,18 € 1053 (https://be.farnell.com/molex/105310-1106/connector-header-6pos-2row-2-5mm/dp/2820682?ost=105310-1106)10-11 (https://befr.rs-online.com/web/p/pcb-headers/1623684)06 - Molex - Pin Header, Power, 2.5 mm (farnell.com) 10531 (https://befr.rs-online.com/web/p/pcb-headers/1623684)0-1106 | Molex, Nano-Fit, 105310, 6 Way, 2 Row, Straight PCB Header | RS Components (rs-online.com) https://www.mouser.be/ProductDetail/Molex/105310-1106?qs=PqFvFmEiOr5yDRWyDD2ubg%3D%3D Pour solénoïde et capteur de pression | Va de paire avec 105308-1206
GR0012 | X3 | PCB connector Bornier 2 voies 3,5mm vertical pluggable | 1 | 9 | / | 0,18 € | 0,18 € https://www.mouser.be/ProductDetail/CUI-Devices/TBP03R2-350-02BE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 Pour l'alimentation | Pas de 3,5mm, vertical, mâle, détrompeur
GR0013 | X4 | Electronic connectorMolex nano-fit 4 pins pitch 2,5mm header | 1 | 9 | / | 1,14 € | 1,14 € https://be.farnell.com/fr-BE/molex/105310-1204/connecteur-header-4pos-2rangees/dp/2576863?st=molex%20nanofit Pour capteurs de niveau
| | | | | | | | | | Va de paire avec 105308-1204
| | | | | | | | | | Maximum 6,5A/pin
| | | | | | | | | | Prévoir crimps 105300-2100
| | | | | | | | | | et retenues 105325-1002
SS7188S-A-NF | X5 | PCB connector Connecteur RJ45 blindé traversant | 1 | 2 | / | 2,78 € | 2,78 € SS-7188S-A-NF (https://befr.rs-online.com/web/p/ethernet-connectors/0437165/) | Bel-Stewart, Female Cat5e RJ45 Connector | RS Components (rs-online.com) Pour thermistances | Blindé
105310-1108 | X6 | Electronic connectorMolex nano-fit 8 pins pitch 2,5mm header | (Y) | 1 | 9 | / | 1,55 € | 1,55 € 1053 (https://be.farnell.com/molex/105310-1108/connector-header-8pos-2row-2-5mm/dp/2820683?ost=105310-1108)10-1108 (https://befr.rs-online.com/web/p/pcb-headers/1623685) - Molex - Pin Header, Power, 2.5 mm (farnell.com) 105310-1108 (https://befr.rs-online.com/web/p/pcb-headers/1623685) | Molex, Nano-Fit, 105310, 8 Way, 2 Row, Straight PCB Header | RS Components (rs-online.com) Pour relais et driver pompe | Va de paire avec 105308-1208
SMAZ5V1-13-F | Z1 | Diode | Diode Zener 5,1V/1W SMA | (Y) | 1 | 1 | / | 0,30 € | 0,30 € SMA (https://www.tme.eu/be/fr/details/smaz5v1-13-f/diodes-zener-smd/diodes-incorporated/)Z5V1-13-F (https://befr.rs-online.com/web/p/zener-diodes/7515054/) DIODES INCORPORATED - Diode: Zener | 1W; 5,1V; 196mA; SMD; rouleau,bande; SMA; diode simple | TME - Composants électroniques SMAZ5V1-13-F (https://befr.rs-online.com/web/p/zener-diodes/7515054/) | Diodes Inc, 5.1V Zener Diode 5% 1 W SMT 2-Pin SMA | RS Components (rs-online.com) 5,1V/1W
DS1023-1*14S21 | PCB connector embase/socket femelle 1*14 voies traversant | (Y) | 2 | 0 | / | 0,14 € | 0,28 € DS1023-1*14S21 (https://www.tme.eu/be/fr/details/zl262-14sg/barres-et-socles-a-broches/connfly/ds1023-1-14s21/) CONNFLY - Socle | broches; femelle; PIN: 14; droit; 2,54mm; THT; 1x14; doré; 3A; ZL262-14SG | TME - Composants électroniques Support Arduino MKR | Pas de 2,54mm, support Arduino MKR
GR0006 | PCB connector embase/socket DIP18 femelle traversant | 1 | 1 | / | 0,26 € | 0,26 € DS1009-18AT1NX (https://www.tme.eu/fr/details/icvt-18p/supports-dip-standard/connfly/ds1009-18at1nx/) CONNFLY - Support: DIP | PIN: 18; 7,62mm; THT; Trame: 2,54mm; ICVT-18P | TME - Composants électroniques Support TBD | Support pour les TBD
P000054 | | Board | Odroid C4 4GB | | 1 | 1 | / | 60,99 € | 60,99 € Odroid (https://www.odroid.nl/index.php?route=product/product&product_id=1027) C4 - 4GB (https://wiki.odroid.com/odroid-c4/hardware/hardware) 64-bit quad-core Single Board Computer odroid-c4:hardware:hardware (https://wiki.odroid.com/odroid-c4/hardware/hardware) [ODROID Wiki] | Alternative au RPi (sans wifi)
P000055 | | Board | Module eMMC 16GB pour Odroid C4 avec Linux | | 1 | 1 | / | 20,99 € | 20,99 € Odroid (https://www.odroid.nl/odroid-accessories/odroid-os?product_id=1029) Operating System - 16GB eMMC Module C4 Linux | Mémoire flash pour Odroid C4 avec Ubuntu 20.04 pré-installé
P000056 | | Board | RTC shield for Odroid C4 (with battery) | | 1 | 1 | / | 6,99 € | 6,99 € Odroid (https://www.odroid.nl/index.php?route=product/product&product_id=1038&search=rtc) RTC Shield for Odroid C4 | Real Time Clock
TBP03P5-350-02BE | Connector | Embase/socket femelle pour bornier 2 voies 3,5mm (Y) | 1 | 9 | / | 0,51 € | 0,51 € https://www.mouser.be/ProductDetail/CUI-Devices/TBP03P5-350-02BE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 Bleu
105308-1204 | Electronic connectorMolex nano-fit 4 pins pitch 2,5mm housing | (Y) | 1 | 9 | / | 0,28 € | 0,28 € 1053 (https://be.farnell.com/molex/105308-1204/connector-rcpt-4pos-2row-2-5mm/dp/2576856?ost=105308-1204)08-1204 (https://befr.rs-online.com/web/p/wire-housings-plugs/1225073) - Molex - Connector Housing, TPA Capable, Nano-Fit 105308 (farnell.com) 105308-1204 (https://befr.rs-online.com/web/p/wire-housings-plugs/1225073) | Molex, Nano-Fit Female Connector Housing, 2.5mm Pitch, 4 Way, 2 Row | RS Components (rs-online.com) Va de paire avec 105310-1104 et 105310-1204
105308-1206 | Electronic connectorMolex nano-fit 6 pins pitch 2,5mm housing | (Y) | 1 | 9 | / | 0,32 € | 0,32 € 105308-1206 (https://befr.rs-online.com/web/p/wire-housings-plugs/1225074) | Molex, Nano-Fit Female Connector Housing, 2.5mm Pitch, 6 Way, 2 Row | RS Components (rs-online.com)
105308-1206 (https://be.farnell.com/molex/105308-1206/connector-rcpt-6pos-2row-2-5mm/dp/2576857?ost=105308-1206) - Molex - Connector Housing, TPA Capable, Nano-Fit 105308 (farnell.com)
| | | | | | | | | | Va de paire avec 105310-1106
| | | | | | | | | | Prévoir crimps 105300-2100
| | | | | | | | | | et retenues 105325-1003
105308-1208 | Electronic connectorMolex nano-fit 8 pins pitch 2,5mm housing | (Y) | 1 | 9 | / | 0,32 € | 0,32 € 105308-1208 (https://befr.rs-online.com/web/p/wire-housings-plugs/1225075) | Molex, Nano-Fit Female Connector Housing, 2.5mm Pitch, 8 Way, 2 Row | RS Components (rs-online.com)
105308-1208 (https://be.farnell.com/molex/105308-1208/connector-rcpt-8pos-2row-2-5mm/dp/2576858?ost=105308-1208) - Molex - Connector Housing, TPA Capable, Nano-Fit 105308 (farnell.com)
| | | | | | | | | | Va de paire avec 105310-1108
| | | | | | | | | | Prévoir crimps 105300-2100
| | | | | | | | | | et retenues 105325-1004
105308-1210 | Electronic connectorMolex nano-fit 10 pins pitch 2,5mm housing | (Y) | 1 | 9 | / | 0,49 € | 0,49 € https://be.farnell.com/molex/105308-1210/conn-housing-rcpt-10pos-2row-2/dp/3221709?st=105308
| | | | | | | | | | Va de paire avec 105310-1110
| | | | | | | | | | Prévoir crimps 105300-2100
| | | | | | | | | | et retenues 105325-1005
105300-2100 | Electronic connectorContact à sertir (crimp) 20 AWG pour Molex nano-fit (Y) | 28 | 100 | / | 0,10 € | 2,83 € https://www.mouser.be/ProductDetail/Molex/105300-2100-Loose-Piece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 https://befr.rs-online.com/web/p/crimp-contacts/1623675 https://be.farnell.com/fr-BE/molex/105300-2100/contact-femelle-22-20awg-a-sertir/dp/2820766?st=105300 Pour aller avec les connecteurs Nano-fit femelles
105325-1002 | Electronic connectorRetenue 2 broches pour bloquer les crimps | (Y) | 2 | 0 | / | 0,13 € | 0,26 € 1053 (https://be.farnell.com/fr-BE/molex/105325-1002/fixation-tpa-nylon-2pos-noir/dp/3049830?ost=1053251002)25-1002 (https://www.mouser.be/ProductDetail/Molex/105325-1002?qs=PqFvFmEiOr6cwlhO3hBeyw%3D%3D) - Molex - Accessoire pour connecteur, Pas de 2.5mm, Retenu pour assurer la position du bornier (farnell.com) 105325-1002 (https://www.mouser.be/ProductDetail/Molex/105325-1002?qs=PqFvFmEiOr6cwlhO3hBeyw%3D%3D) Molex | Mouser Belgique 1 pour chaque côté | Va de paire avec 105308-1204
105325-1003 | Electronic connectorRetenue 3 broches pour bloquer les crimps | (Y) | 2 | 0 | / | 0,12 € | 0,23 € 1053 (https://be.farnell.com/fr-BE/molex/105325-1003/fixation-tpa-nylon-3pos-noir/dp/3049831?ost=1053251003)25-1003 (https://www.mouser.be/ProductDetail/Molex/105325-1003?qs=PqFvFmEiOr6g807aLFfxSw%3D%3D) - Molex - Accessoire pour connecteur, Pas de 2.5mm, Retenu pour assurer la position du bornier (farnell.com) 105325-1003 (https://www.mouser.be/ProductDetail/Molex/105325-1003?qs=PqFvFmEiOr6g807aLFfxSw%3D%3D) Molex | Mouser Belgique 2 pour chaque côté | Va de paire avec 105308-1206
105325-1004 | Electronic connectorRetenue 4 broches pour bloquer les crimps | (Y) | 2 | 0 | / | 0,13 € | 0,26 € 1053 (https://be.farnell.com/fr-BE/molex/105325-1004/fixation-tpa-nylon-4pos-noir/dp/3049832?ost=1053251004)25-1004 (https://www.mouser.be/ProductDetail/Molex/105325-1004?qs=PqFvFmEiOr7zoqhrqnCsiA%3D%3D) - Molex - Accessoire pour connecteur, Pas de 2.5mm, Retenu pour assurer la position du bornier (farnell.com) 105325-1004 (https://www.mouser.be/ProductDetail/Molex/105325-1004?qs=PqFvFmEiOr7zoqhrqnCsiA%3D%3D) Molex | Mouser Belgique 3 pour chaque côté | Va de paire avec 105308-1208
105325-1005 | Electronic connectorRetenue 5 broches pour bloquer les crimps | (Y) | 2 | 0 | / | 0,12 € | 0,24 € 1053 (https://be.farnell.com/fr-BE/molex/105325-1005/retenue-tpa-5-voies-nylon/dp/3222475?ost=1053251005)25-1005 (https://www.mouser.be/ProductDetail/Molex/105325-1005?qs=PqFvFmEiOr6lGvmcCpFelg%3D%3D) - Molex - Accessoire pour connecteur, , Retenu pour assurer la position du bornier (farnell.com) 105325-1005 (https://www.mouser.be/ProductDetail/Molex/105325-1005?qs=PqFvFmEiOr6lGvmcCpFelg%3D%3D) Molex | Mouser Belgique 4 pour chaque côté | Va de paire avec 105308-1210
P000066 | | Board | PCB MICHAv4.0 | | 1 | 2 | / | 32,68 € | 32,68 € https://www.eurocircuits.com | Carte perso MICHA

### MICHA_V4.0
