AKUINO/MICHA/MICHA20/Technical documentations/MICHA20_Arduino_pinUsage.jpg

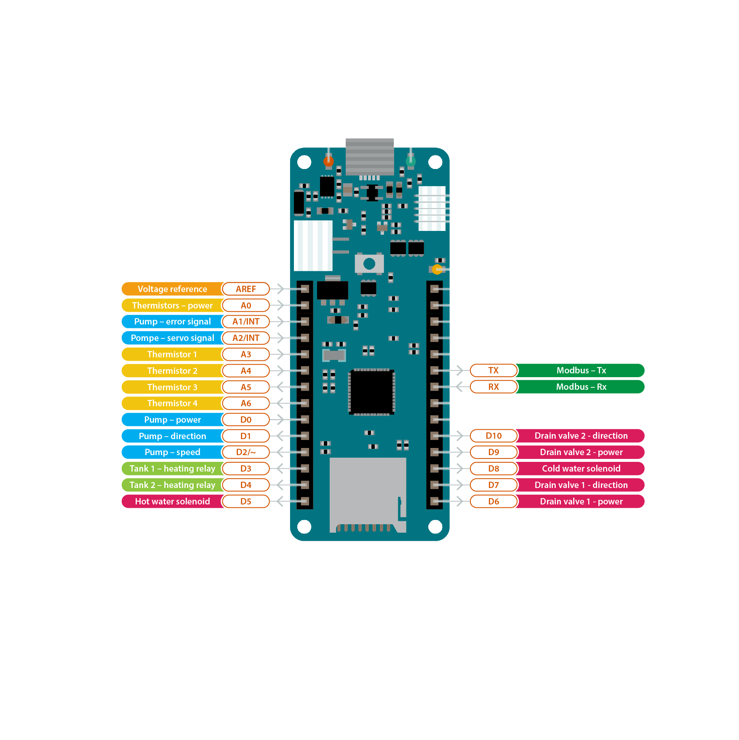
MICHA20/Technical documentations/MICHA20_Arduino_pinUsage.jpg
