AKUINO/MICHA/MICHA20/Technical documentations/MICHA20_RPi_pinUsage.jpg

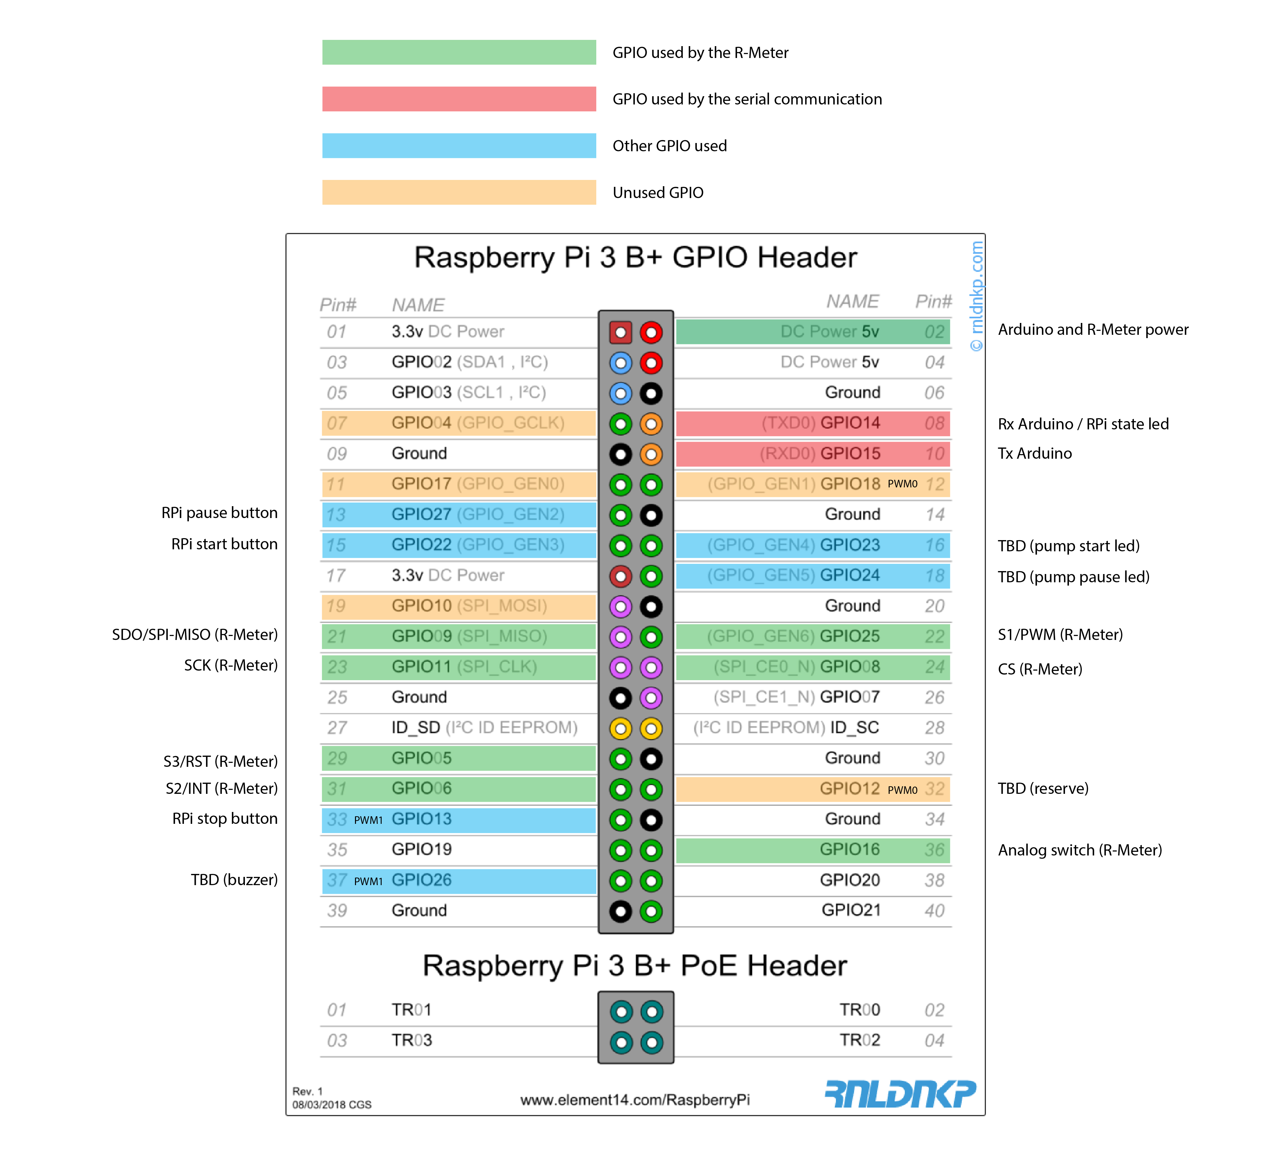
MICHA20/Technical documentations/MICHA20_RPi_pinUsage.jpg
