AKUINO/MICHA/MICHA40/Technical documentations/MICHA40_Arduino_pinUsage.jpg

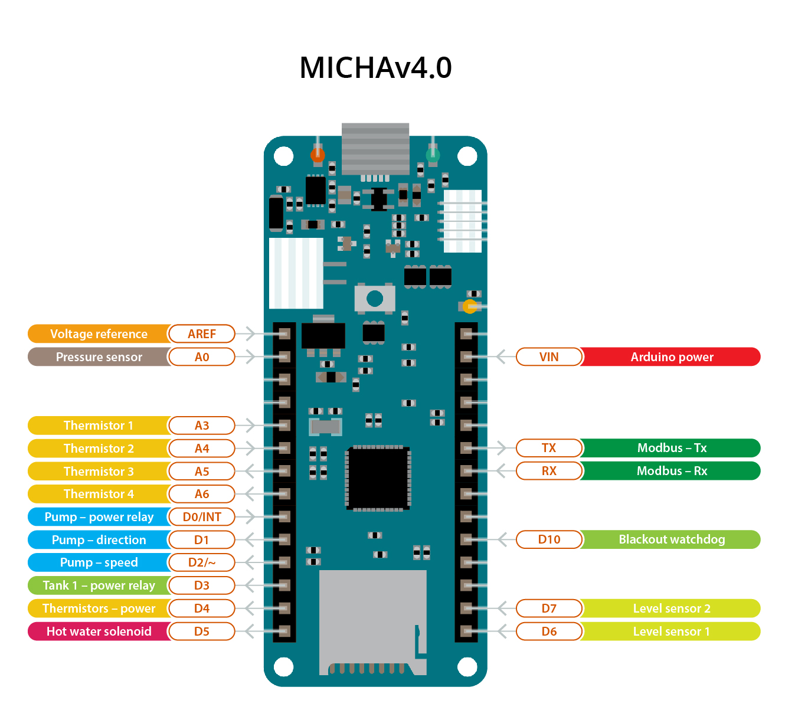
MICHA40/Technical documentations/MICHA40_Arduino_pinUsage.jpg
