AKUINO/MICHA/MICHA40/Technical documentations/MICHA40_RPi_pinUsage.jpg

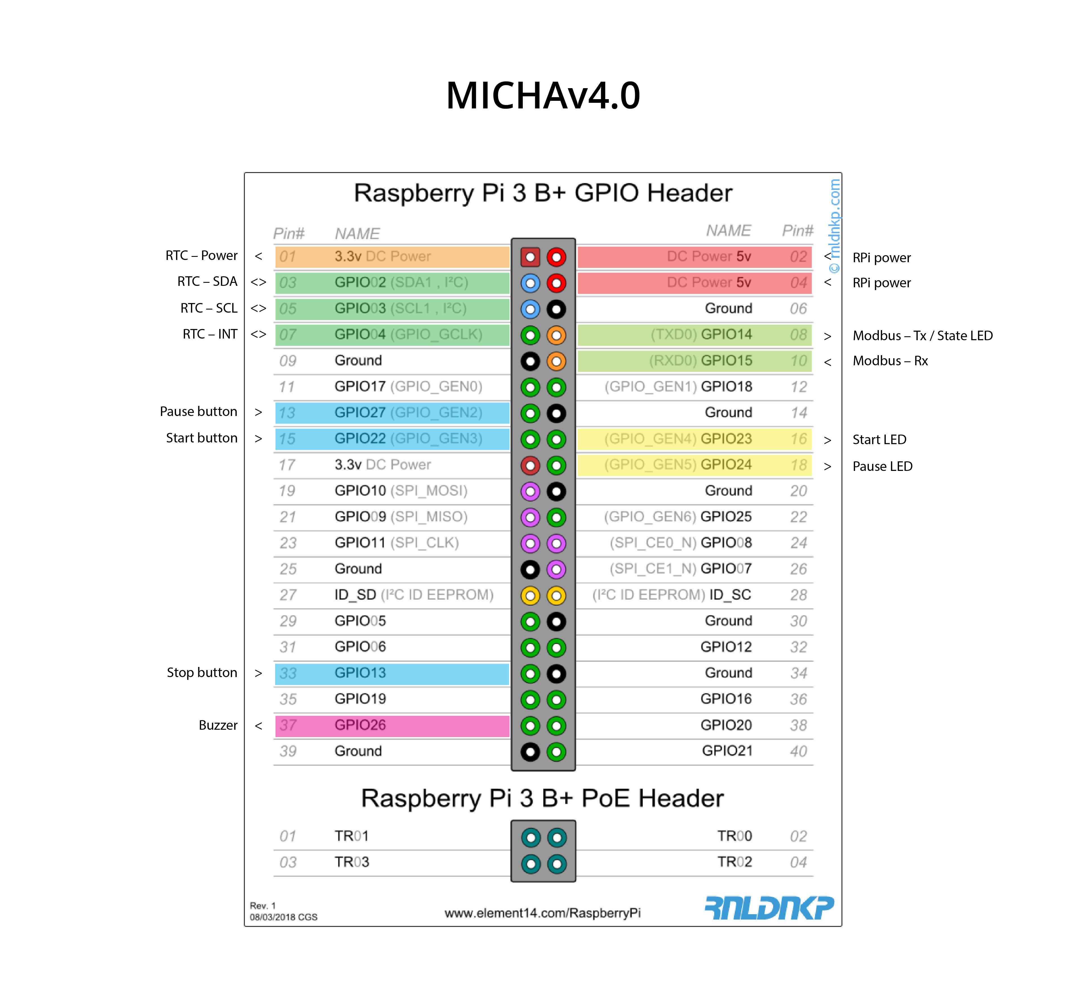
MICHA40/Technical documentations/MICHA40_RPi_pinUsage.jpg
