AKUINO/MICHA/MICHA50/Technical documentations/MICHA50_Arduino_pinsUsage.pdf

# MICHAv5.0

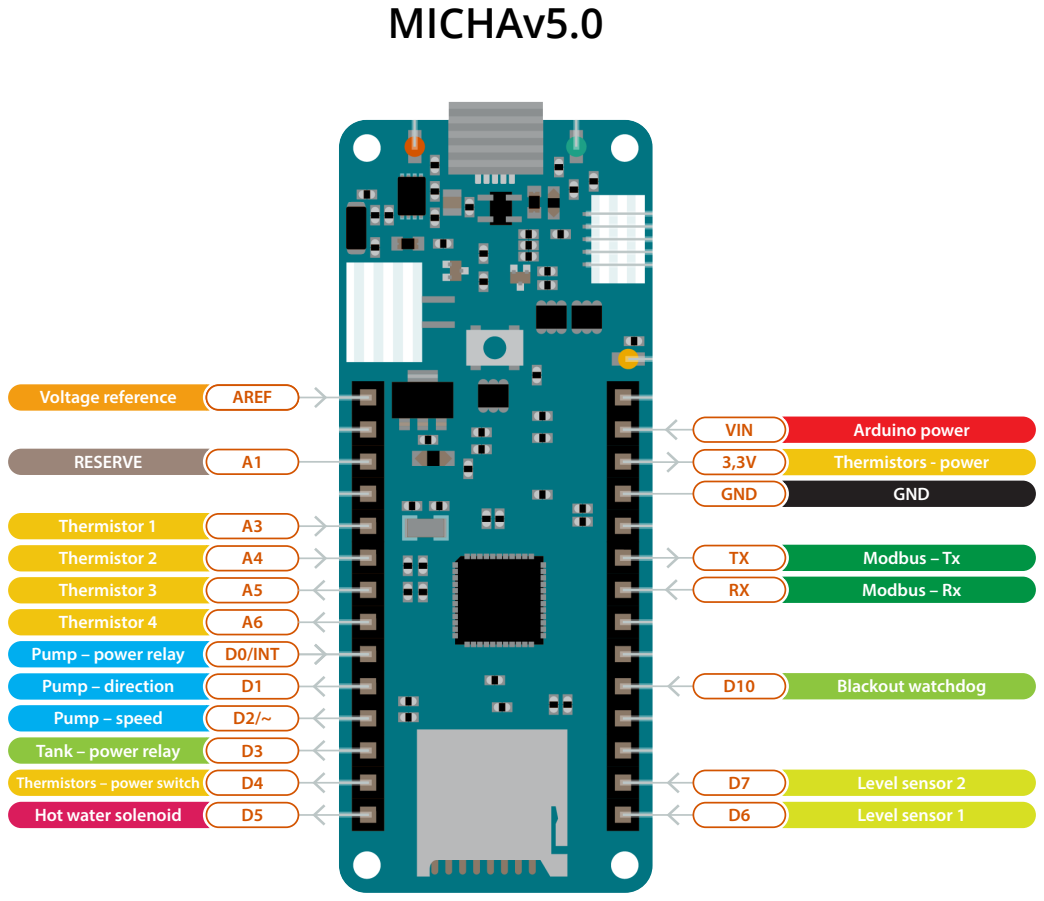
[picture p7: page 1]
AREF; Voltage reference; RESERVE; Thermistor 1; Thermistor 4; Thermistor 2; Thermistor 3; Pump – power relay; D0/INT; Pump – direction; Pump – speed; Tank – power relay; Thermistors – power switch; Hot water solenoid; Level sensor 1; Level sensor 2; Blackout watchdog; Modbus – Rx; Modbus – Tx; Thermistors - power; GND; VIN; Arduino power
