AKUINO/MICHA/MICHA50/Technical documentations/MICHE50_RPi-Odroid_pinsUsage.pdf

# MICHAv5.0

## GPIO Header

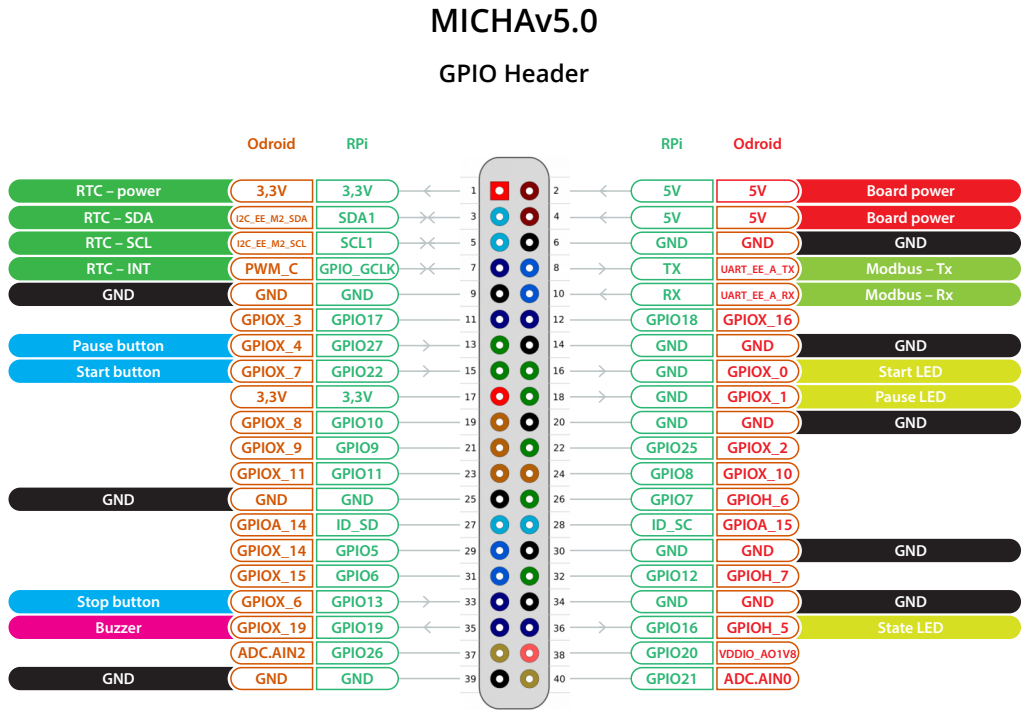
[picture p8: page 1]
CS (R-Meter); S1/PWM (R-Meter); TBD (reserve); TBD (buzzer); SCK (R-Meter); Unused GPIO; PWM0; PWM1; RTC – power; Board power; GND; UART_EE_A_TX; Modbus – Tx; UART_EE_A_RX; Modbus – Rx; GPIO18; GPIOX_16; GPIOX_0; Start LED; GPIOX_1; Pause LED; GPIO25; GPIOX_2; GPIO8; GPIOX_10; GPIO7; GPIOH_6; GPIOA_15; GPIO12; GPIOH_7; GPIO16; GPIOH_5; State LED; GPIO20 VDDIO_AO1V8; GPIO21; ADC.AIN0; RTC – SDA; I2C_EE_M2_SDA; SDA1; RTC – SCL; I2C_EE_M2_SCL; SCL1; RTC – INT; PWM_C GPIO_GCLK; GPIOX_3; GPIO17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

GPIO used by the R-Meter

GPIO used by the serial communication

Other GPIO used

Arduino and R-Meter power

Rx Arduino / RPi state led
Tx Arduino

RPi pause button
RPi start button

TBD (pump start led)
TBD (pump pause led)

SDO/SPI-MISO (R-Meter)

S3/RST (R-Meter)
S2/INT (R-Meter)
RPi stop button

Analog switch (R-Meter)
