AKUINO/MICHA/MICHA50/Technical documentations/connecteurs.pdf

## CONNECTEURS

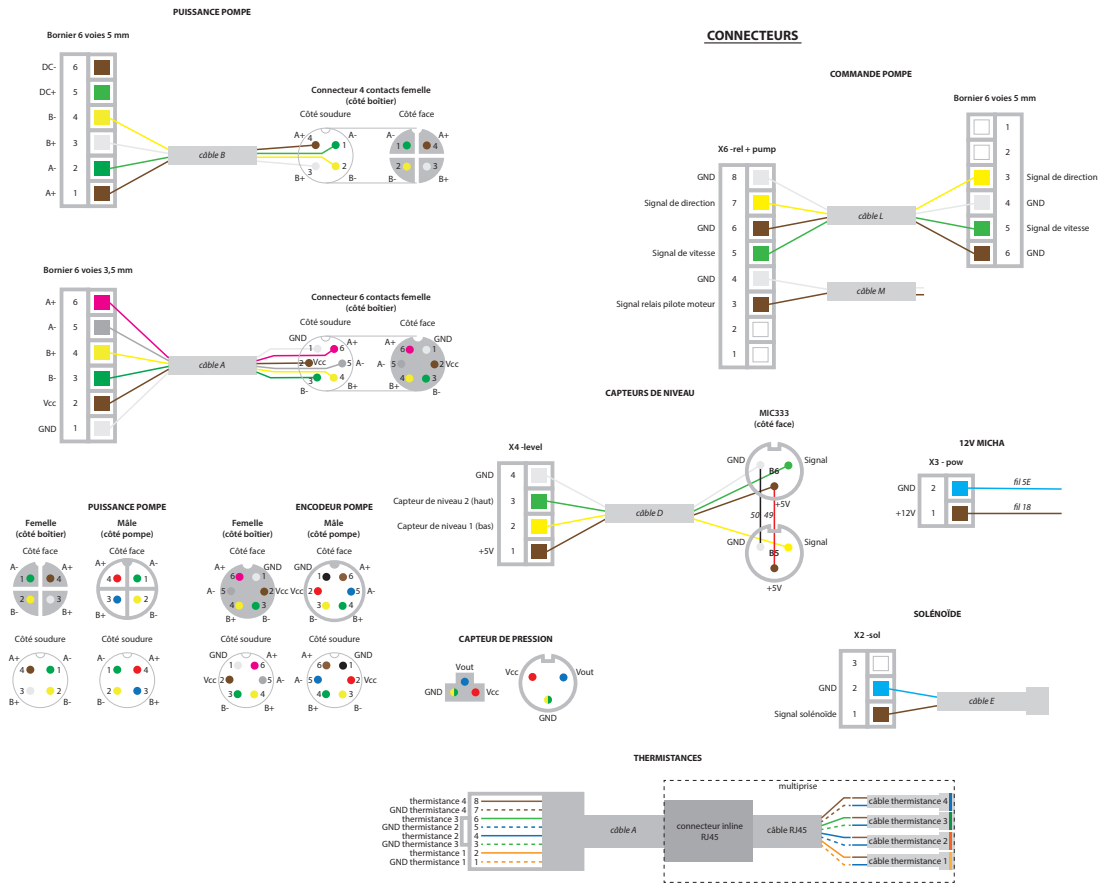
[picture p9: page 1]
GND; Vcc; Côté face; Côté soudure; PUISSANCE POMPE; ENCODEUR POMPE; COMMANDE POMPE; Femelle (côté boîtier); Mâle (côté pompe); X6 -rel + pump; câble L; câble B; câble A; câble M; (côté boîtier); Vout; MIC333 (côté face); X4 -level; câble D; Signal; GND thermistance 1 1; thermistance 1 2; GND thermistance 3; thermistance 2; GND thermistance 2; thermistance 3; GND thermistance 4 7; thermistance 4 8; câble RJ45 connecteur inline; câble thermistance 4; câble thermistance 3; câble thermistance 2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

Bornier 6 voies 5 mm

Connecteur 4 contacts femelle

Signal de direction

Signal de vitesse

Bornier 6 voies 3,5 mm

Connecteur 6 contacts femelle

Signal relais pilote moteur

CAPTEURS DE NIVEAU

Capteur de niveau 2 (haut)

Capteur de niveau 1 (bas)

CAPTEUR DE PRESSION
