AKUINO/MICHA/MICHA40/Eagle/MICHAv40.brd

## EAGLE design MICHA40/Eagle/MICHAv40.brd (2022-04-22)

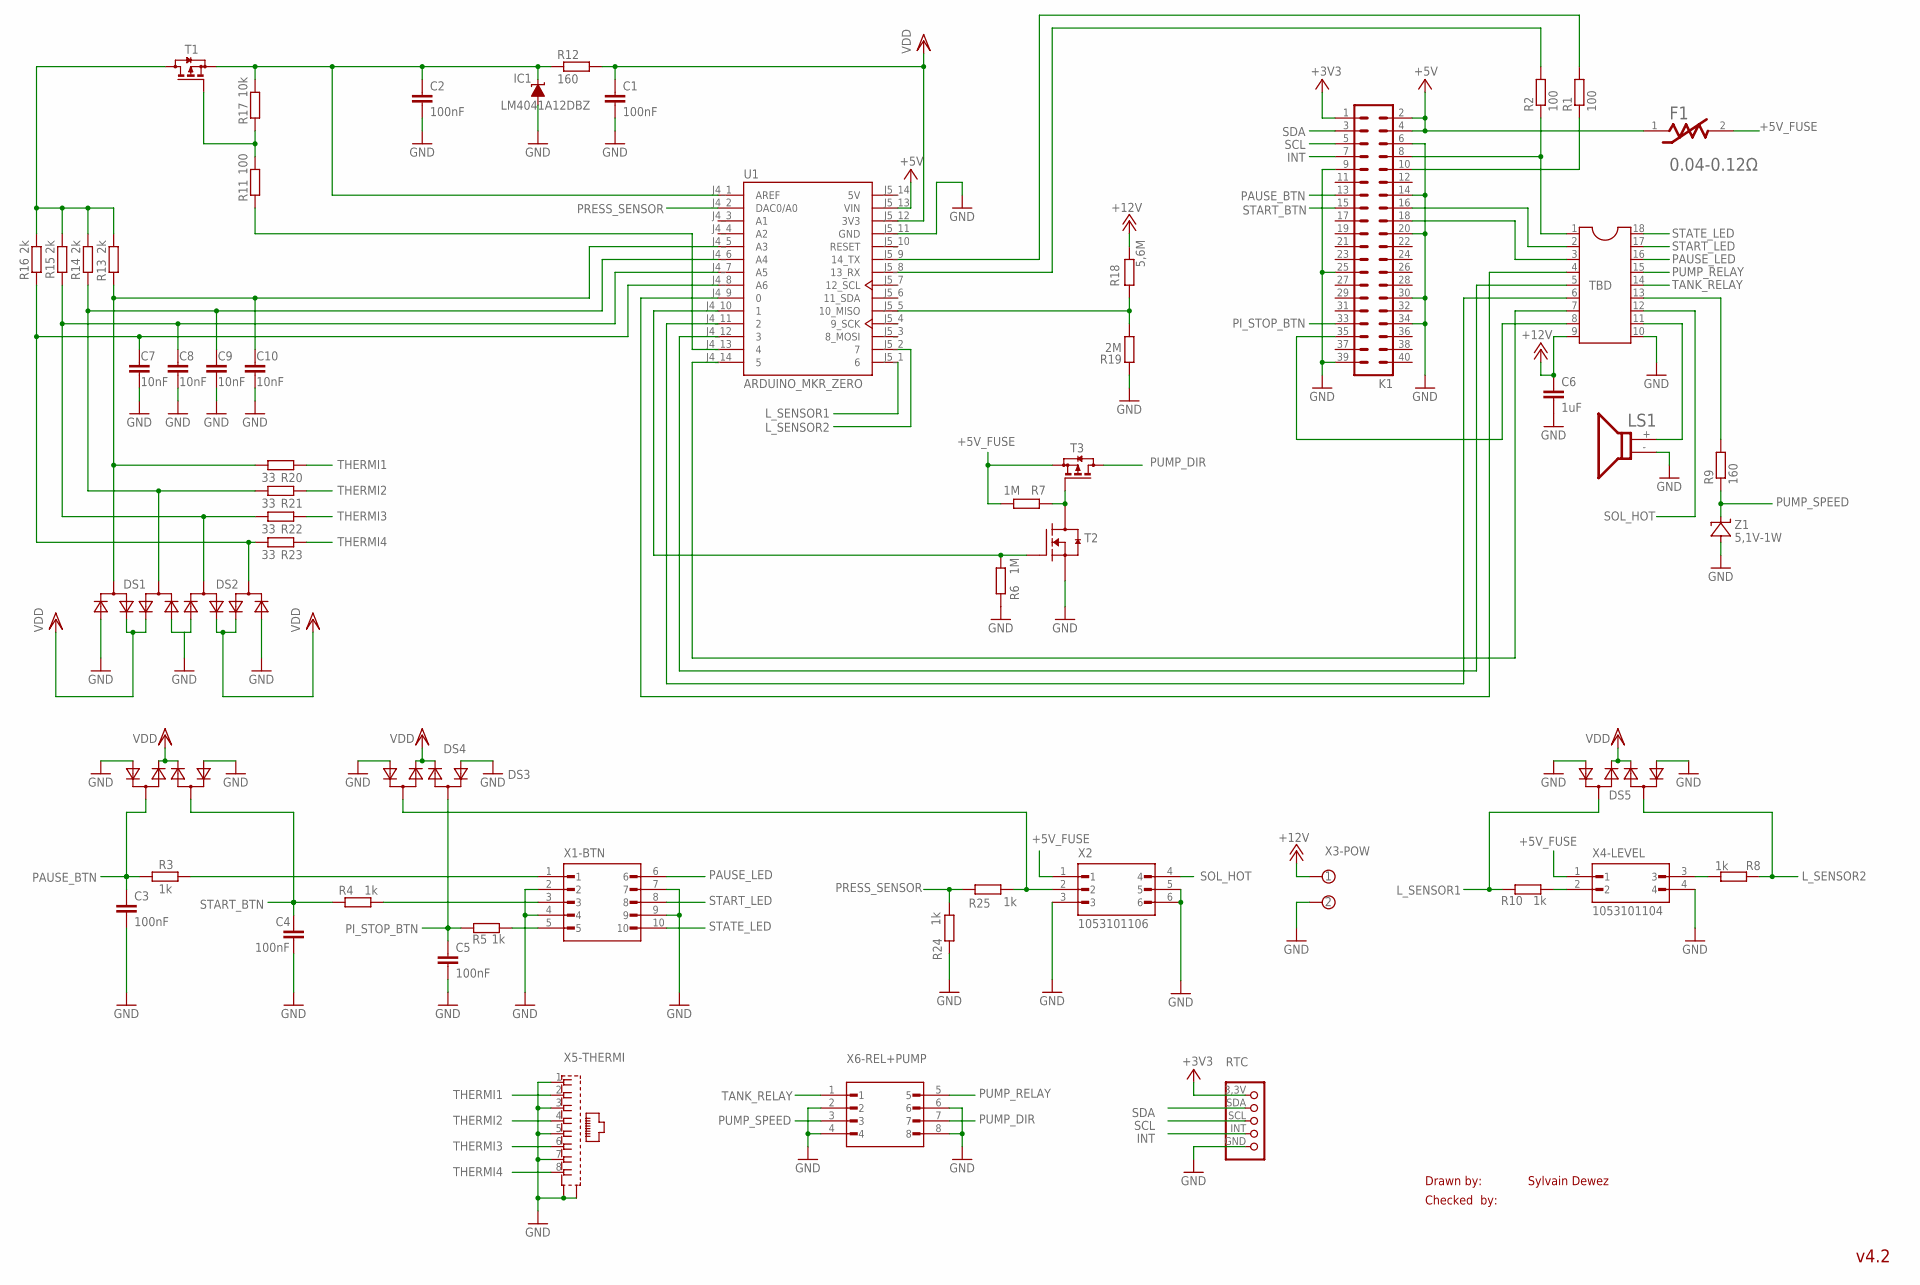
[picture p10: schematic MICHAv40.sch]

Parts:
C1, C2, C3, C4, C5: 100nF; C1206
C6: 1uF; C1206
C7, C8, C9, C10: 10nF; C1206
DS1, DS2, DS3, DS4, DS5: CMXSH2-4LSTRPBFREE
F1: LITTELFUSE_INC_1206L150THWRLITTELFUSE_INC_1206L15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; LITTELFUSE_INC_1206L150THWR_0
IC1: LM4041A12DBZ; DBZ_R-PDSO-G3
K1: PIN20X2; PIN_20X2
LS1: RSPRO-BUZZER-7800743
R1, R2, R11: 100; R1206
R3, R4, R5, R8, R10, R24, R25: 1k; R1206
R6, R7: 1M; R1206
R9, R12: 160; R1206
R13, R14, R15, R16: 2k; R1206
R17: 10k; R1206
R18: 5,6M; R1206
R19: 2M; R1206
R20, R21, R22, R23: 33; R1206
RTC: ODROID_C4_RTC_SHIELD
T1, T3: BSS84; SOT23
T2: MOSFET-NCH_SOT-23; SOT95P280X135-3N
TBD: DIL18S; SOCKET-18
U1: ARDUINO_MKR_ZERO; MODULE_ARDUINO_MKR_ZERO
X1-BTN: 1053101110; MOLEX_1053101110
X2: 1053101106; MOLEX_1053101106
X3-POW: BUCHANAN_2_3.2MM; BUCHANAN_2_3.5MM
X4-LEVEL: 1053101104; MOLEX_1053101104
X5-THERMI: SS-7188S-A-NF_V2; BEL_SS-7188S-A-NF
X6-REL+PUMP: 1053101108; MOLEX_1053101108
Z1: 5,1V-1W; ZENER_SMA

Connections:
5V: U1.J5_14 (5V)
+3V3: K1.1, RTC.3,3V (1)
+5V: F1.1, K1.2, K1.4, U1.J5_13 (VIN)
+5V_FUSE: F1.2, R7.2, T3.2 (S), X2.1, X4-LEVEL.1
+12V: C6.1, R18.2, TBD.9, X3-POW.1 (KL)
BLACKOUT: R18.1, R19.2, U1.J5_5 (10_MISO)
BTN_PAUSE: R3.2, X1-BTN.1
BTN_START: R4.2, X1-BTN.3
BTN_STOP: R5.2, X1-BTN.5
D0: TBD.4, U1.J4_9 (0)
D1: R6.2, T2.1 (G), U1.J4_10 (1)
D2: TBD.6, U1.J4_11 (2)
D3: TBD.5, U1.J4_12 (3)
D5: TBD.7, U1.J4_14 (5)
D21: R11.1, U1.J4_13 (4)
GND: C1.2, C2.2, C3.2, C4.2, C5.2, C6.2, C7.2, C8.2, C9.2, C10.2, DS1.1 (A3), DS1.6 (A2), DS2.1 (A3), DS2.6 (A2), DS3.1 (A3), DS3.6 (A2), DS4.1 (A3), DS4.6 (A2), DS5.1 (A3), DS5.6 (A2), IC1.2 (A), K1.6, K1.9, K1.14, K1.20, K1.25, K1.30, K1.34, K1.39, LS1.- (2), R6.1, R19.1, R24.1, RTC.GND (5), T2.2 (S), TBD.10, U1.J5_11 (GND), X1-BTN.2, X1-BTN.4, X1-BTN.7, X1-BTN.9, X2.3, X2.5, X2.6, X3-POW.2 (KL1), X4-LEVEL.4, X5-THERMI.1, X5-THERMI.3, X5-THERMI.5, X5-THERMI.7, X5-THERMI.S1 (GND1), X5-THERMI.S2 (GND2), X6-REL+PUMP.2, X6-REL+PUMP.4, X6-REL+PUMP.6, X6-REL+PUMP.8, Z1.A
INT: K1.7, RTC.INT (4)
L_SENSOR1: DS5.5 (C), R10.1, U1.J5_1 (6)
L_SENSOR2: DS5.2 (C1), R8.1, U1.J5_2 (7)
unnamed: R9.2, TBD.13
unnamed: R11.2, R17.1, T1.1 (G)
unnamed: C2.1, IC1.1 (C), R12.1, R17.2, T1.2 (S), U1.J4_1 (AREF)
unnamed: R13.1, R14.1, R15.1, R16.1, T1.3 (D)
unnamed: C10.1, DS1.2 (C1), R13.2, R20.1, U1.J4_5 (A3)
unnamed: C9.1, DS1.5 (C), R14.2, R21.1, U1.J4_6 (A4)
unnamed: C8.1, DS2.2 (C1), R15.2, R22.1, U1.J4_7 (A5)
unnamed: C7.1, DS2.5 (C), R16.2, R23.1, U1.J4_8 (A6)
unnamed: LS1.+ (1), TBD.11
unnamed: R7.1, T2.3 (D), T3.1 (G)
PAUSE_BTN: C3.1, DS3.5 (C), K1.13, R3.1
PAUSE_LED: TBD.16, X1-BTN.6
PI16: K1.16, TBD.2
PI18: K1.18, TBD.3
PI33: K1.35, TBD.8
PI_STOP_BTN: C5.1, DS4.2 (C1), K1.33, R5.1
PRESS_SENSOR: R24.2, R25.1, U1.J4_2 (DAC0/A0)
PUMP_DIR: T3.3 (D), X6-REL+PUMP.7
PUMP_RELAY: TBD.15, X6-REL+PUMP.5
PUMP_SPEED: R9.1, X6-REL+PUMP.3, Z1.C
RX_A: R2.2, U1.J5_8 (13_RX)
RX_PI: K1.10, R1.1
SCL: K1.5, RTC.SCL (3)
SDA: K1.3, RTC.SDA (2)
SENSOR: DS4.5 (C), R25.2, X2.2
SENSOR1: R10.2, X4-LEVEL.2
SENSOR2: R8.2, X4-LEVEL.3
SOL_HOT: TBD.12, X2.4
START_BTN: C4.1, DS3.2 (C1), K1.15, R4.1
START_LED: TBD.17, X1-BTN.8
STATE_LED: TBD.18, X1-BTN.10
TANK_RELAY: TBD.14, X6-REL+PUMP.1
THERMI1: R20.2, X5-THERMI.2
THERMI2: R21.2, X5-THERMI.4
THERMI3: R22.2, X5-THERMI.6
THERMI4: R23.2, X5-THERMI.8
TX_A: R1.2, U1.J5_9 (14_TX)
TX_PI: K1.8, R2.1, TBD.1
VDD: C1.1, DS1.3 (A4), DS1.4 (A1), DS2.3 (A4), DS2.4 (A1), DS3.3 (A4), DS3.4 (A1), DS4.3 (A4), DS4.4 (A1), DS5.3 (A4), DS5.4 (A1), R12.2, U1.J5_12 (3V3)

Notes on the sheet:
Drawn by:
Checked by:
Sylvain Dewez
v4.2

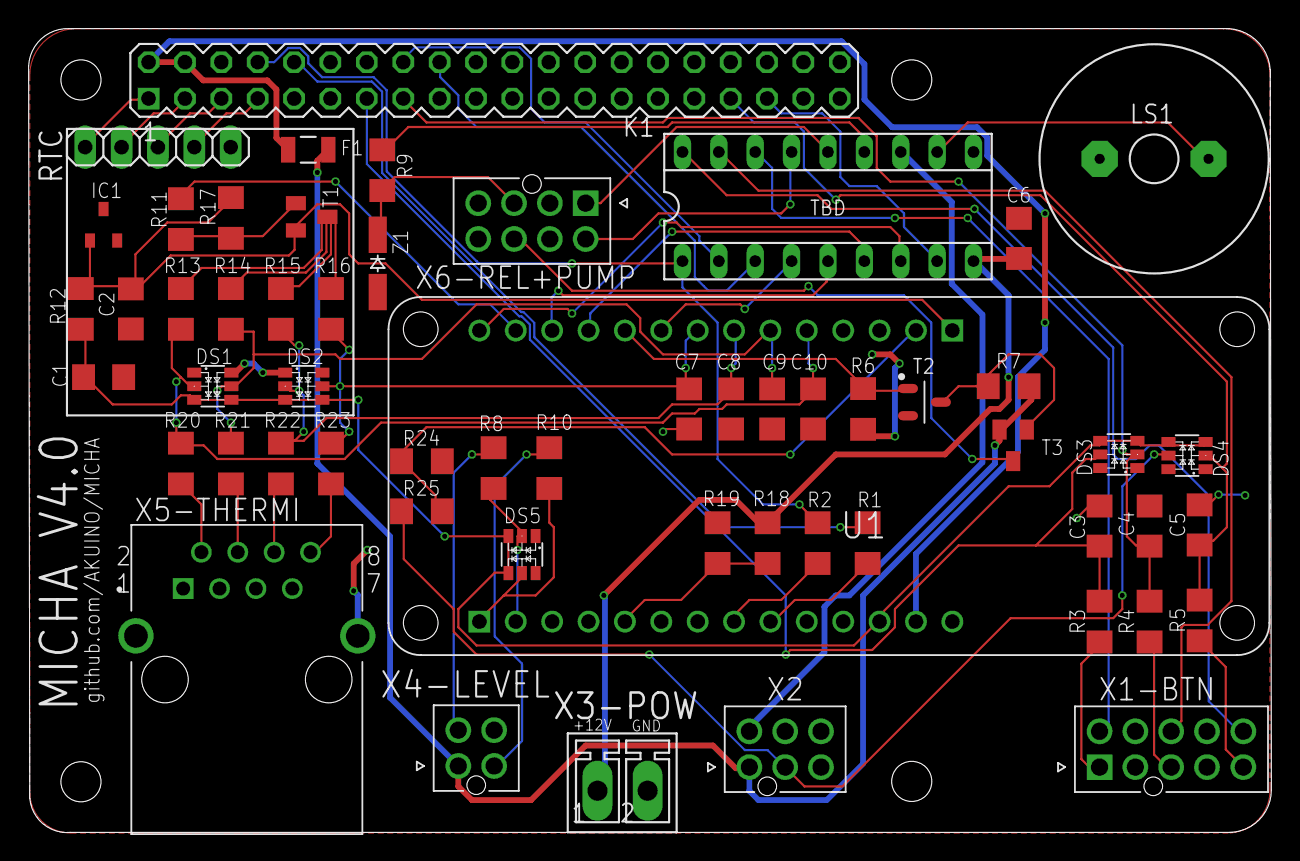
[picture p11: board MICHAv40.brd from above]

Board: 2 copper layers, 86.8 x 56.1 mm, 57 parts (0 on the bottom side), 57 nets.
