AKUINO/MICHA/MICHA20/Eagle/MICHA20.brd

## EAGLE design MICHA20/Eagle/MICHA20.brd (2021-05-12)

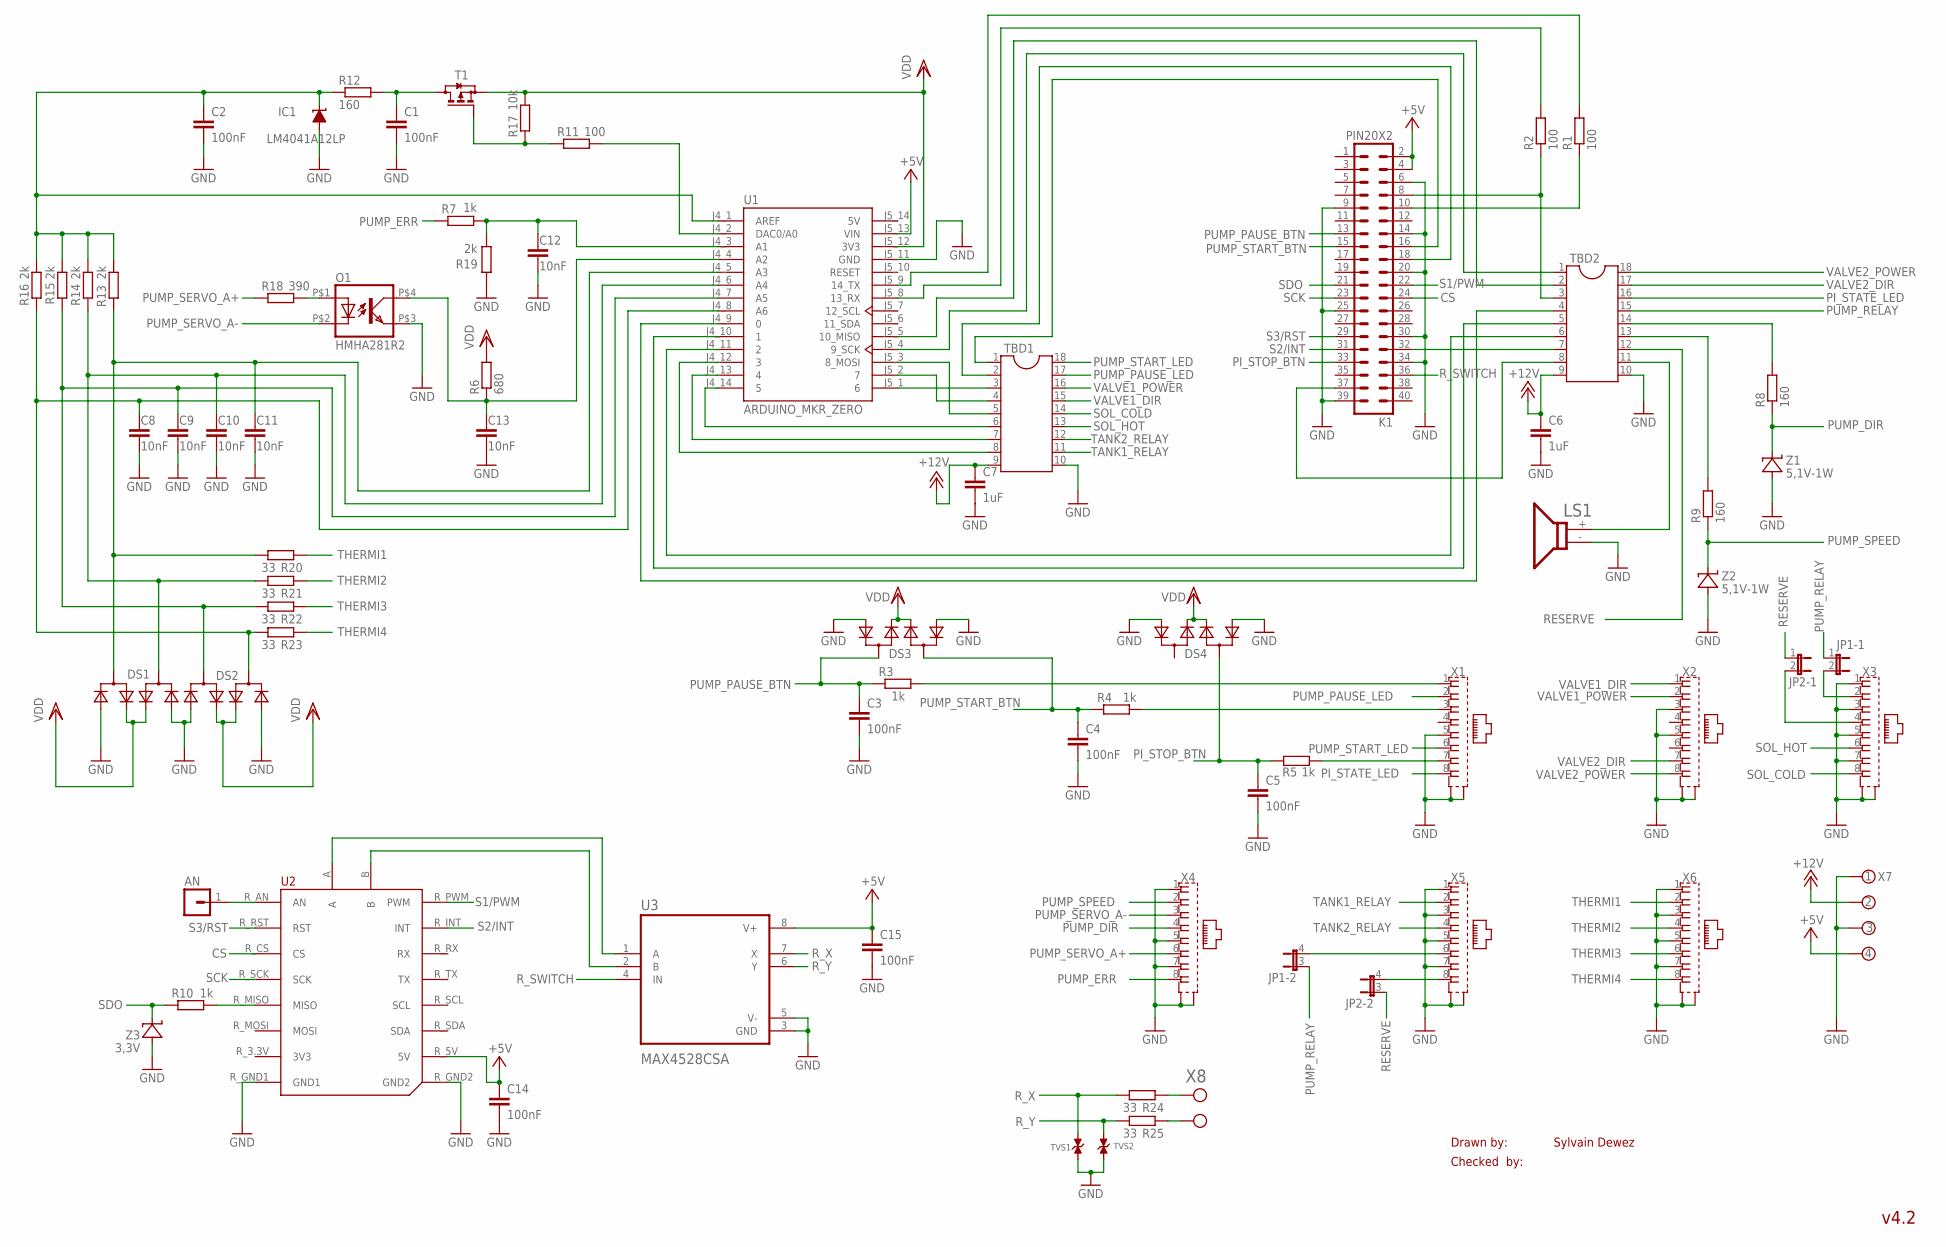
[picture p12: schematic MICHA20.sch]

Parts:
AN: MA01_PINHEADER; MA01
C1, C2, C3, C4, C5, C14, C15: 100nF; C1206
C6, C7: 1uF; C1206
C8, C9, C10, C11, C12, C13: 10nF; C1206
DS1, DS2, DS3, DS4: SDM10M45SD; SDM10M45SD_SOT-26
IC1: LM4041A12LP; LP_O-PBCY-W3
JP1, JP2: JP2QE; JP2Q
K1: PIN20X2; PIN_20X2
LS1: RSPRO-BUZZER-7800743
O1: HMHA281R2
R1, R2, R11: 100; R1206
R3, R4, R5, R7, R10: 1k; R1206
R6: 680; R1206
R8, R9, R12: 160; R1206
R13, R14, R15, R16, R19: 2k; R1206
R17: 10k; R1206
R18: 390; R1206
R20, R21, R22, R23, R24, R25: 33; R1206
T1: BSS84; SOT23
TBD1, TBD2: DIL18S; SOCKET-18
TVS1, TVS2: TVS_SOD123
U1: ARDUINO_MKR_ZERO; MODULE_ARDUINO_MKR_ZERO
U2: MIKROE_CLICK_UPGRADE; MIKROE_BUS_MIDI_UPGRADE
U3: MAX4528CSA; SOIC127P600X175-8N
X1, X2, X3, X4, X5, X6: SS-7188S-A-NF_V2; BEL_SS-7188S-A-NF
X7: BUCHANAN_4_3.5MM
X8: MPT_0,5/_2-2,54_1725656_2; PH_MPT_0,5/_2-2,54_1725656
Z1, Z2: 5,1V-1W; ZENER_SMA
Z3: 3,3V; ZENER_SMA

Connections:
5V: U1.J5_14 (5V)
+5V: C14.1, C15.1, K1.2, K1.4, U1.J5_13 (VIN), U2.R_5V (5V), U3.8 (V+), X7.4 (KL3)
+12V: C6.1, C7.1, TBD1.9, TBD2.9, X7.2 (KL1)
CS: K1.24, U2.R_CS (CS)
D0: TBD2.4, U1.J4_9 (0)
D1: TBD2.5, U1.J4_10 (1)
D2: TBD2.6, U1.J4_11 (2)
D3: TBD1.8, U1.J4_12 (3)
D4: TBD1.7, U1.J4_13 (4)
D5: TBD1.6, U1.J4_14 (5)
D6: TBD1.3, U1.J5_1 (6)
D7: TBD1.4, U1.J5_2 (7)
D8: TBD1.5, U1.J5_3 (8_MOSI)
D9: TBD2.1, U1.J5_4 (9_SCK)
D10: TBD2.2, U1.J5_5 (10_MISO)
D19: C12.1, R7.2, R19.2, U1.J4_3 (A1)
D21: R11.2, U1.J4_2 (DAC0/A0)
GND: C1.2, C2.2, C3.2, C4.2, C5.2, C6.2, C7.2, C8.2, C9.2, C10.2, C11.2, C12.2, C13.2, C14.2, C15.2, DS1.1 (A2), DS1.4 (A3), DS2.1 (A2), DS2.4 (A3), DS3.1 (A2), DS3.4 (A3), DS4.1 (A2), DS4.4 (A3), IC1.3 (A), K1.6, K1.9, K1.14, K1.20, K1.25, K1.30, K1.34, K1.39, LS1.- (2), O1.P$3 (EMIT), R19.1, TBD1.10, TBD2.10, TVS1.P$2 (C1), TVS2.P$2 (C1), U1.J5_11 (GND), U2.R_GND1 (GND1), U2.R_GND2 (GND2), U3.3 (GND), U3.5 (V-), X1.5, X1.S1 (GND1), X1.S2 (GND2), X2.3, X2.5, X2.S1 (GND1), X2.S2 (GND2), X3.1, X3.3, X3.5, X3.7, X3.S1 (GND1), X3.S2 (GND2), X4.1, X4.5, X4.7, X4.S1 (GND1), X4.S2 (GND2), X5.1, X5.3, X5.5, X5.7, X5.S1 (GND1), X5.S2 (GND2), X6.1, X6.3, X6.5, X6.7, X6.S1 (GND1), X6.S2 (GND2), X7.1 (KL), X7.3 (KL2), Z1.A, Z2.A, Z3.A
unnamed: U2.B, U3.2 (B)
unnamed: R9.2, TBD2.13
unnamed: R11.1, R17.1, T1.1 (G)
unnamed: R8.2, TBD2.14
unnamed: R4.2, X1.3
unnamed: C2.1, IC1.2 (C), R12.1, R13.1, R14.1, R15.1, R16.1, U1.J4_1 (AREF)
unnamed: O1.P$1 (A), R18.2
unnamed: C1.1, R12.2, T1.3 (D)
unnamed: C13.1, O1.P$4 (COL), R6.1, U1.J4_4 (A2)
unnamed: U2.A, U3.1 (A)
unnamed: C11.1, DS1.3 (C1), R13.2, R20.1, U1.J4_5 (A3)
unnamed: C10.1, DS1.6 (C), R14.2, R21.1, U1.J4_6 (A4)
unnamed: C9.1, DS2.3 (C1), R15.2, R22.1, U1.J4_7 (A5)
unnamed: C8.1, DS2.6 (C), R16.2, R23.1, U1.J4_8 (A6)
unnamed: R10.2, U2.R_MISO (MISO)
unnamed: AN.1, U2.R_AN (AN)
unnamed: R24.2, X8.2 (KL1)
unnamed: R25.2, X8.1 (KL)
unnamed: JP1.4 (2), X5.6
unnamed: JP1.2, X3.2
unnamed: JP2.4 (2), X5.8
unnamed: JP2.2, X3.4
unnamed: R3.2, X1.1
unnamed: R5.2, X1.7
unnamed: LS1.+ (1), TBD2.11
PI16: K1.16, TBD1.1
PI18: K1.18, TBD1.2
PI32: K1.32, TBD2.7
PI33: K1.37, TBD2.8
PI_STATE_LED: TBD2.16, X1.8
PI_STOP_BTN: C5.1, DS4.3 (C1), K1.33, R5.1
PUMP_DIR: R8.1, X4.4, Z1.C
PUMP_ERR: R7.1, X4.8
PUMP_PAUSE_BTN: C3.1, DS3.6 (C), K1.13, R3.1
PUMP_PAUSE_LED: TBD1.17, X1.2
PUMP_RELAY: JP1.1, JP1.3 (1), TBD2.15
PUMP_SERVO_A+: R18.1, X4.6
PUMP_SERVO_A-: O1.P$2 (C), X4.3
PUMP_SPEED: R9.1, X4.2, Z2.C
PUMP_START_BTN: C4.1, DS3.3 (C1), K1.15, R4.1
PUMP_START_LED: TBD1.18, X1.6
RESERVE: JP2.1, JP2.3 (1), TBD2.12
RX_A: R2.2, U1.J5_8 (13_RX)
RX_PI: K1.10, R1.1
R_SWITCH: K1.36, U3.4 (IN)
R_X: R24.1, TVS1.P$1 (C), U3.7 (X)
R_Y: R25.1, TVS2.P$1 (C), U3.6 (Y)
S1/PWM: K1.22, U2.R_PWM (PWM)
S2/INT: K1.31, U2.R_INT (INT)
S3/RST: K1.29, U2.R_RST (RST)
SCK: K1.23, U2.R_SCK (SCK)
SDO: K1.21, R10.1, Z3.C
SOL_COLD: TBD1.14, X3.8
SOL_HOT: TBD1.13, X3.6
TANK1_RELAY: TBD1.11, X5.2
TANK2_RELAY: TBD1.12, X5.4
THERMI1: R20.2, X6.2
THERMI2: R21.2, X6.4
THERMI3: R22.2, X6.6
THERMI4: R23.2, X6.8
TX_A: R1.2, U1.J5_9 (14_TX)
TX_PI: K1.8, R2.1, TBD2.3
VALVE1_DIR: TBD1.15, X2.1
VALVE1_POWER: TBD1.16, X2.2
VALVE2_DIR: TBD2.17, X2.7
VALVE2_POWER: TBD2.18, X2.8
VDD: DS1.2 (A1), DS1.5 (A4), DS2.2 (A1), DS2.5 (A4), DS3.2 (A1), DS3.5 (A4), DS4.2 (A1), DS4.5 (A4), R6.2, R17.2, T1.2 (S), U1.J5_12 (3V3)

Notes on the sheet:
Drawn by:
Checked by:
Sylvain Dewez
v4.2

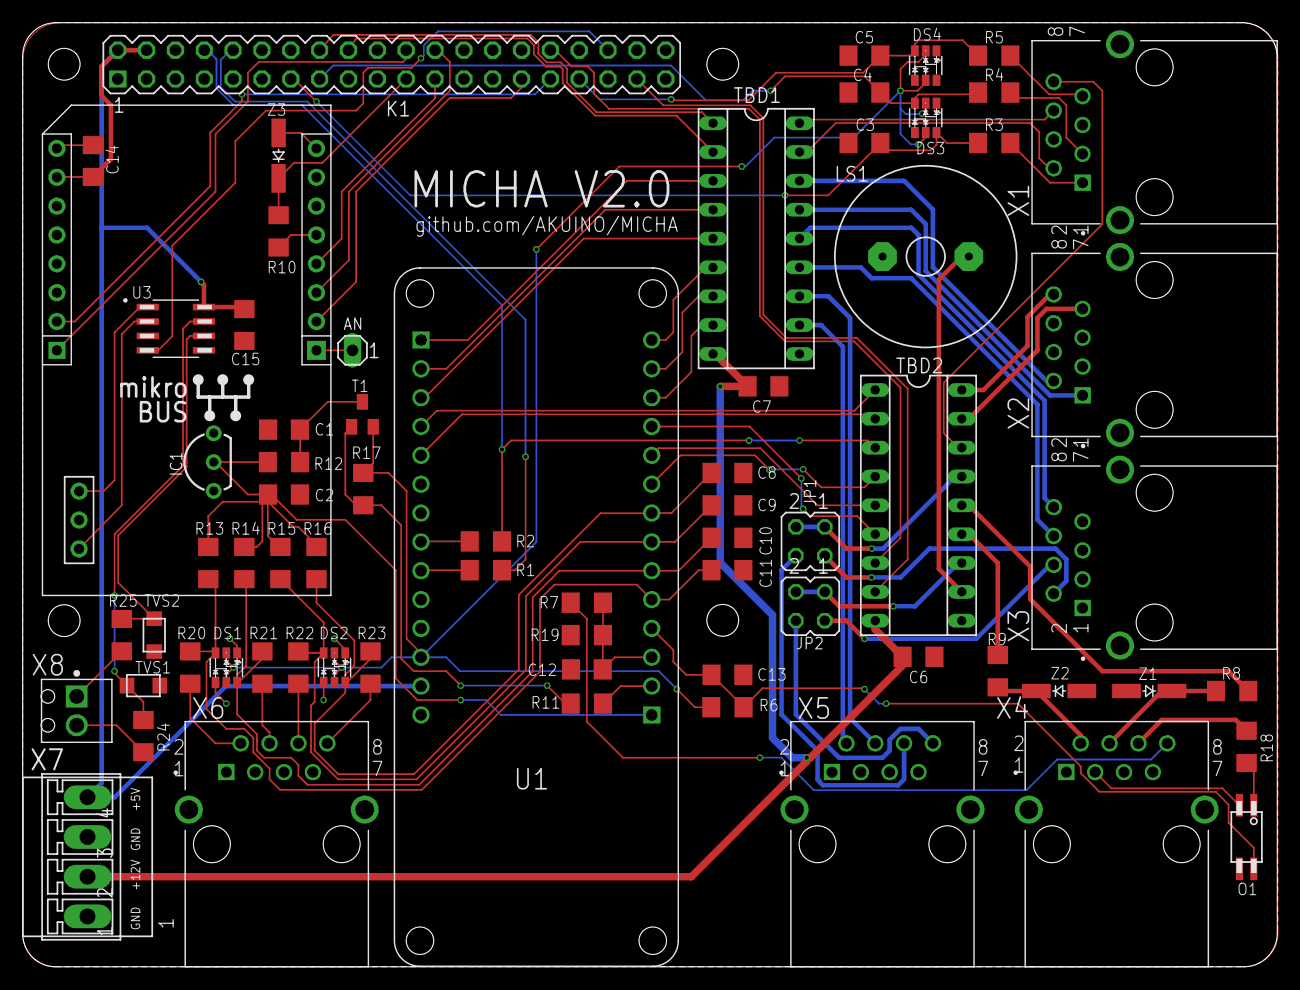
[picture p13: board MICHA20.brd from above]

Board: 2 copper layers, 110.5 x 83.1 mm, 70 parts (0 on the bottom side), 84 nets.
