AKUINO/MICHA/(commit log)

2021-03-27 premiers ajouts
    [BOM.xlsx, MICHA.brd, MICHA.sch]
2021-04-06 I/O update
    Switching between the speed pin and the power pin of the pump
2021-04-08 Update Structure registres modbus.docx
    Ajoit du registre "témoin de démarrage"
2021-04-08 thermistor value in mV
2021-04-09 Counting servo at each second
2021-04-12 Speed and power pump pins modified
    - Voltage tags on X7
    - Output valve names updated
    [MICHA.brd, MICHA.sch]
2021-04-13 Pump servo pin updated
    Modification of the next pins:
    - Thermis power -> A0
    - Error pump -> A1
    - Servo pin -> A2
    - Thermi 1 -> A3
    - Thermi 2 -> A4
    - Thermi 3 -> A5
    - Thermi 4 -> A6
    [MICHA.brd, MICHA.sch]
2021-04-14 v1.1.2
    - reading and decoding the pump error signal implemented (writing in register not yet implemented)
    - loop section reorganized
2021-04-16 PUMP_SERVO_PIN correction
    The name was wrong --> corrected
    Switching to input_pullup mode
2021-04-16 Poll pump error pin every 35 ms
2021-04-16 moins de delay
2021-04-16 Interrupt for Servo
2021-04-21 v1.1.3 - pump servo registers updated
2021-04-21 Pump servo registers updated
2021-04-22 interrupt servo test
    Test codes to count the pulse number and the period of the pump servo signal
2021-04-23 Delete schéma projet global.jpg
    Merge the same file ames
2021-04-23 v1.1.4
    pump servo signal decoding implemented
2021-04-23 v1.1.4 – debug register added
    Debug mode by register implemented
2021-04-23 Update for next PCB
    [MICHA_nextPCB(servoA2).brd, MICHA_nextPCB(servoA2).sch]
2021-04-23 Downgrade to current version of PCB
    [MICHA.brd, MICHA.sch]
2021-04-23 Update for next PCB version
    [BOM_nextPCB(serviA2).xlsx, MICHA_nextPCB(servoA2).brd, MICHA_nextPCB(servoA2).sch]
2021-04-26 BOM and inventory updated
    [BOM_nextPCB(serviA2).xlsx, inventory.xlsx]
2021-04-27 MICHA_nextPCB updated
    - analog switch added
    - zener and tvs for protection added
    - schottky diode deleted
    - error signal go through a bridge divider instead of a zener
    [MICHA_nextPCB(servoA2).brd, MICHA_nextPCB(servoA2).sch]
2021-04-27 MICHA_nextPCB eagle files updated
    3.3V source of Mikro deleted
    [MICHA_nextPCB(servoA2).brd, MICHA_nextPCB(servoA2).sch]
2021-04-27 BOM updated
    [BOM_nextPCB(serviA2).xlsx, inventory.xlsx]
2021-04-28 Inventory modified
    [BOM_nextPCB(serviA2).xlsx, inventory.xlsx]
2021-04-29 Btn & thermis zener replaced by Schottky
    [MICHA_nextPCB(servoA2).brd, MICHA_nextPCB(servoA2).sch]
2021-04-29 Schottky added
    [BOM_nextPCB(serviA2).xlsx, inventory.xlsx]
2021-04-29 Button diodes between resistor and capacitor
    [MICHA_nextPCB(servoA2).brd]
2021-04-29 Update 33 ohm resistor
    [BOM_nextPCB(serviA2).xlsx, inventory.xlsx]
2021-04-30 add jumpers for reserve and pump_relay
    [MICHA_nextPCB(servoA2).brd, MICHA_nextPCB(servoA2).sch]
2021-04-30 Mikrobus footprint updated
    [MICHA_nextPCB(servoA2).brd, MICHA_nextPCB(servoA2).sch]
2021-05-07 tNames updated
    Add +12V and +5V labels
    [MICHA_nextPCB(servoA2).brd]
2021-05-07 Components for MICHA v2 added
    [BOM_nextPCB(serviA2).xlsx, inventory.xlsx]
2021-05-07 Name updated
    [BOM_MICHAv1.0.xlsx, BOM_MICHAv2.0.xlsx, MICHAv1.0.brd, MICHAv1.0.sch, MICHAv2.0.brd, MICHAv2.0.sch]
2021-05-08 Quantity updated
    [BOM_MICHAv2.0.xlsx, inventory.xlsx]
2021-05-10 Dissociation of V1 and V2 PCB
2021-05-10 Dissociation of the V1 and V2 PCB
2021-05-12 MAX4528CSA footprint updated
    [MICHAv2.0.brd, MICHAv2.0.sch]
2021-05-12 Optocoupler footprint updated
    [MICHAv2.0.brd, MICHAv2.0.sch]
2022-03-18 Renommer les fichiers INO
2022-04-22 Suppression des dossier MICHA et tests
2022-04-22 Nettoyage
    Suppression des fichiers en rapport avec le version 1 et autres
    [BOM_MICHAv1.0.xlsx, inventory.xlsx]
2022-04-22 Pré-nettoyage
    [BOM_MICHAv2.0.xlsx, MICHAv1.0.brd, MICHAv1.0.sch, MICHAv2.0.brd, MICHAv2.0.sch]
2022-04-22 Nettoyage + uniformisation
    [BOM_MICHAv2.0.xlsx, MICHA20.brd, MICHA20.sch, MICHAv40.brd, MICHAv40.sch]
2022-04-22 Mise à jours des BOM
    [BOM_MICHAv2.0.xlsx]
2022-04-28 Ajout de MICHA41
    [MICHAv41.brd, MICHAv41.sch]
2022-05-05 Pressure management
2026-10-01 Managing flow sensor on level 2 (output)
    [MICHA20.brd, MICHA20.sch, MICHAv40.brd, MICHAv40.sch, MICHAv41.brd, MICHAv41.sch]
