AKUINO/MICHA/(notices)

Notices in the files:
parts and their libraries:
EMCComponents: Copyright: Würth Elektronik
